pscorbett/ScannerVibrato-Eurorack/README.md

# ScannerVibrato-Eurorack
Scanner vibrato eurorack module that uses digital logic chips (no MCU) to perform the scanning across the LC ladder.
