pscorbett/ScannerVibrato-Eurorack/Mechanical/ScannerVibrato20HP_3D-Assembly.step

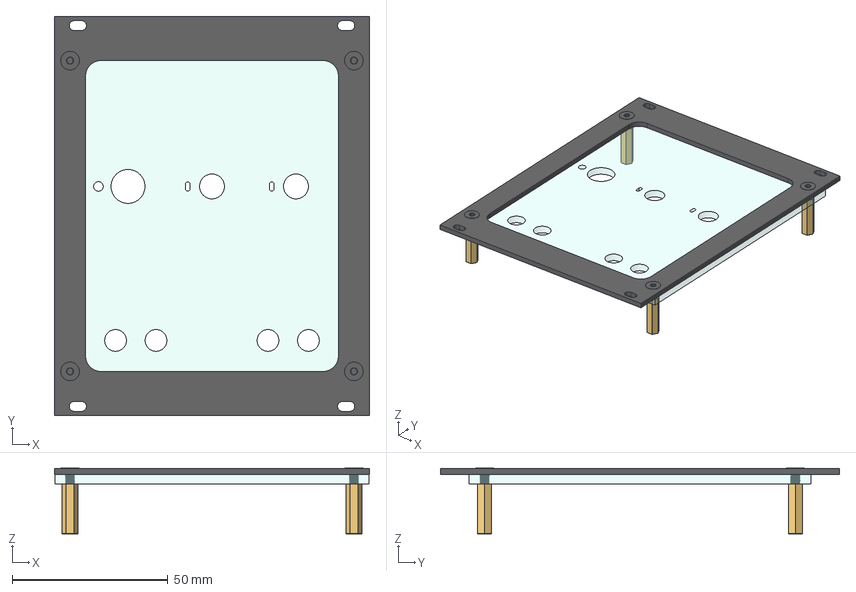
[picture p1: CAD file, 2025-08-02]
Mechanical/ScannerVibrato20HP_3D-Assembly.step
101.3 x 128.4 x 21.1 mm
Frame002
Window001
95440A104_Black-Oxide 316 Stainless Steel Hex Drive Flat Head Screw x 4
95440A104_Black-Oxide 316 Stainless Steel Hex Drive Flat Head Screw001 x 4
