pscorbett/ScannerVibrato-Eurorack/Electronics/Boards/ScannerVibrato_Main/ScannerVibratoFun_Eurorack-Bottom Signal.dxf

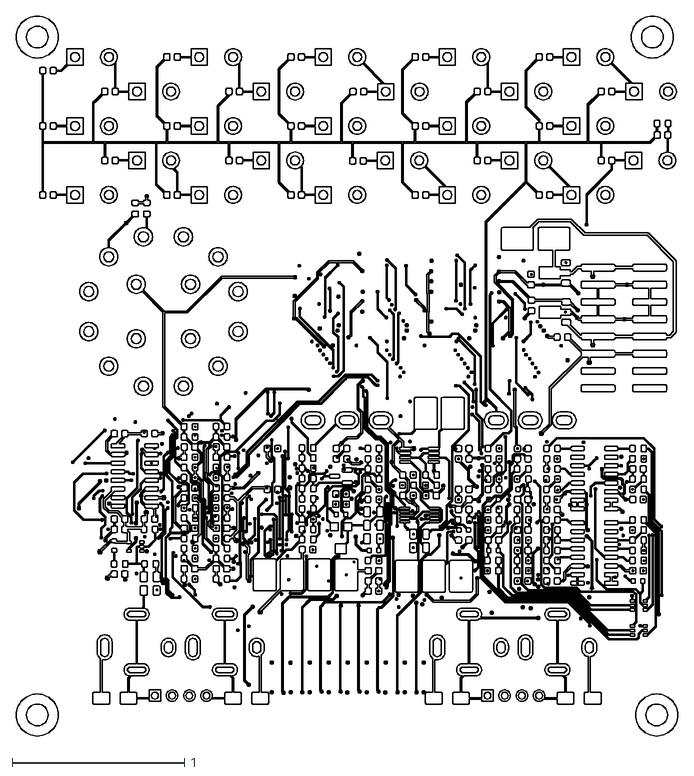
[picture p2: CAD file, 2025-08-02]
Electronics/Boards/ScannerVibrato_Main/ScannerVibratoFun_Eurorack-Bottom Signal.dxf
3.84 x 4.18
