pscorbett/ScannerVibrato-Eurorack/Mechanical/ScannerVibrato20HP_3D-Window001Sketch005.dxf

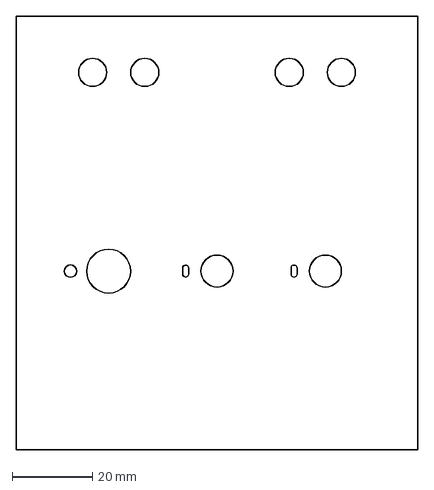
[picture p3: CAD file, 2025-08-02]
Mechanical/ScannerVibrato20HP_3D-Window001Sketch005.dxf
100.0 x 108.0 mm
