pscorbett/ScannerVibrato-Eurorack/Electronics/Boards/ScannerVibrato_Main/ScannerVibratoFun_Eurorack-Board Outline.dxf

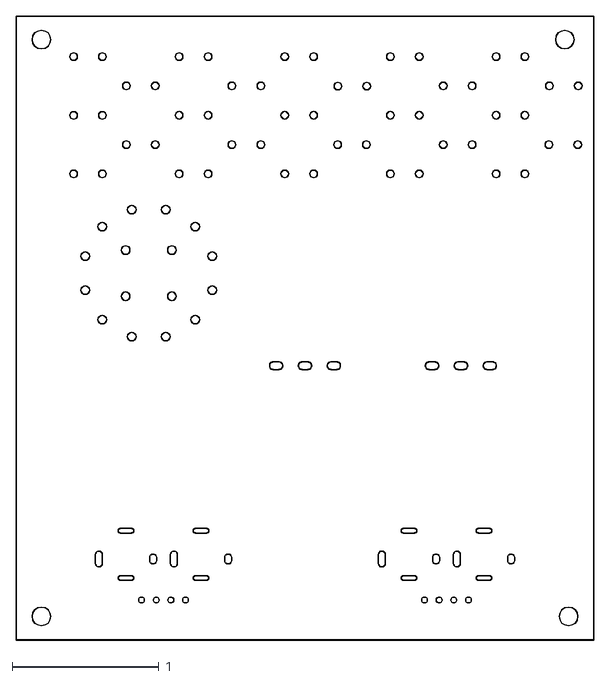
[picture p4: CAD file, 2025-08-02]
Electronics/Boards/ScannerVibrato_Main/ScannerVibratoFun_Eurorack-Board Outline.dxf
3.94 x 4.25
