pscorbett/ScannerVibrato-Eurorack/Mechanical/ScannerVibrato20HP_3D-PanelSketch010.dxf

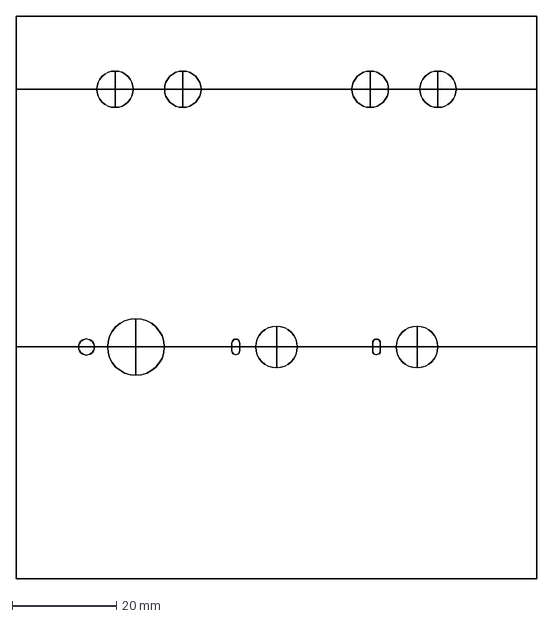
[picture p5: CAD file, 2025-08-02]
Mechanical/ScannerVibrato20HP_3D-PanelSketch010.dxf
100.0 x 108.0 mm
