pscorbett/ScannerVibrato-Eurorack/Electronics/Boards/ScannerVibrato_Main/ScannerVibratoFun_Eurorack-Top Signal.dxf

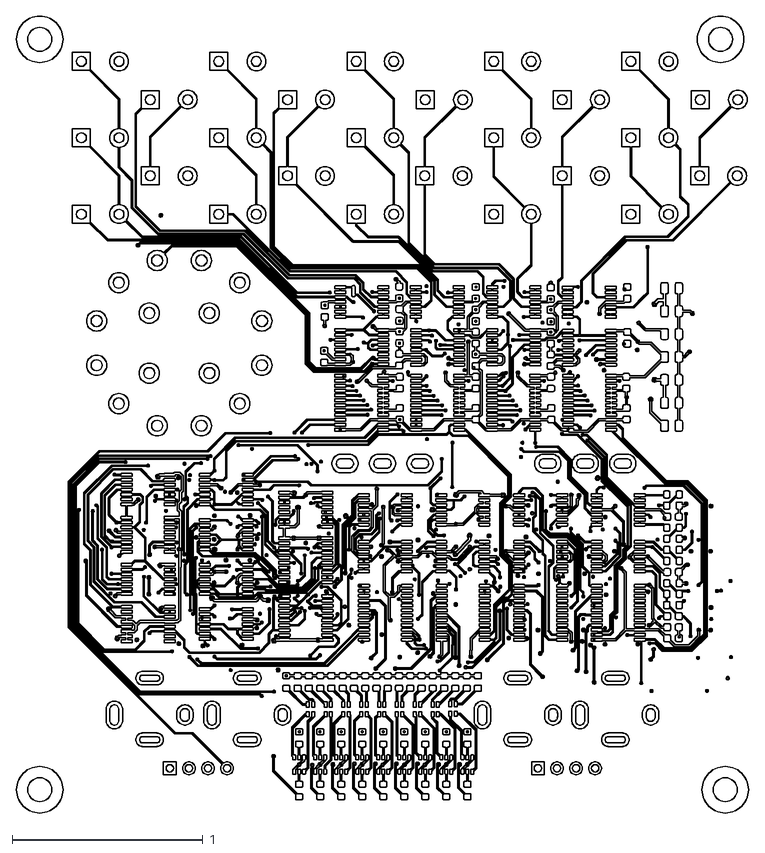
[picture p6: CAD file, 2025-08-02]
Electronics/Boards/ScannerVibrato_Main/ScannerVibratoFun_Eurorack-Top Signal.dxf
3.84 x 4.18
