pscorbett/ScannerVibrato-Eurorack/Mechanical/ScannerVibrato20HP_3D-PanelSketch007.dxf

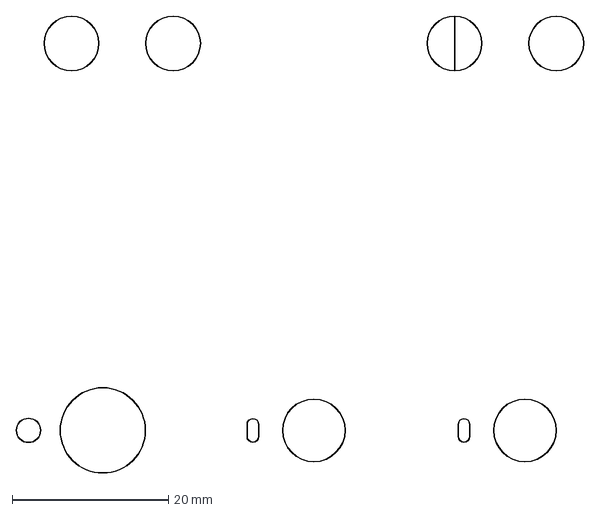
[picture p7: CAD file, 2025-08-02]
Mechanical/ScannerVibrato20HP_3D-PanelSketch007.dxf
72.5 x 58.5 mm
