pscorbett/ScannerVibrato-Eurorack/Mechanical/ScannerVibrato20HP_3D-PartWindow.dxf

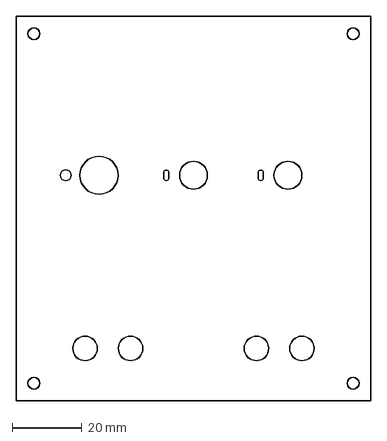
[picture p8: CAD file, 2025-08-02]
Mechanical/ScannerVibrato20HP_3D-PartWindow.dxf
101.3 x 109.9 mm
