pscorbett/ScannerVibrato-Eurorack/(list of files, cad)

Other CAD files:
Electronics/Boards/ScannerVibrato_Main/ScannerVibratoFun_Eurorack-Bottom Silkscreen.dxf
Electronics/Boards/ScannerVibrato_Main/ScannerVibratoFun_Eurorack-Top Silkscreen.dxf
