pscorbett/ScannerVibrato-Eurorack/Electronics/Boards/ScannerVibrato_IO/ScannerVibrato_IO.kicad_pcb

## KiCad design Electronics/Boards/ScannerVibrato_IO/ScannerVibrato_IO.kicad_pcb (2025-08-02)

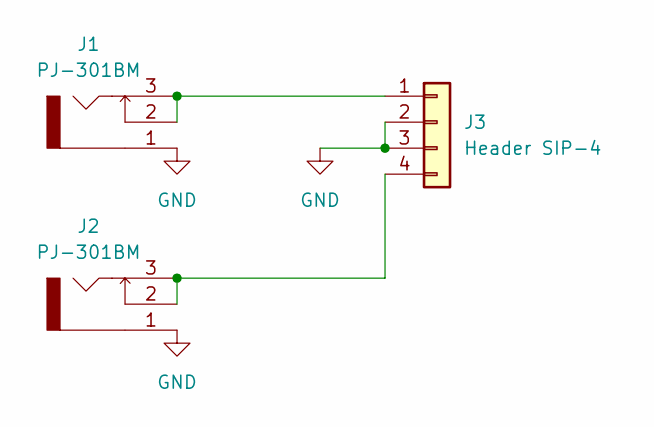
[picture p9: schematic ScannerVibrato_IO.kicad_sch, Scanner Vibrato IO]

Parts:
J1, J2: PJ-301BM; Part Number PJ-301BM
J3: Header SIP-4; PinHeader_1x04_P2.54mm_Vertical; Part Number PH1-04-UA

Connections:
GND: J1.1 (S), J2.1 (S), J3.2, J3.3
unnamed: J1.2 (SW), J1.3 (T), J3.1
unnamed: J2.2 (SW), J2.3 (T), J3.4

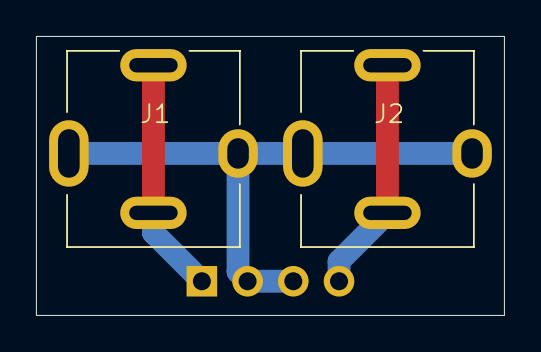
[picture p10: board ScannerVibrato_IO.kicad_pcb from above]

Board: 2 copper layers, 26.0 x 15.5 mm, 3 parts (1 on the bottom side), 3 nets.
