pscorbett/ScannerVibrato-Eurorack/Electronics/Boards/ScannerVibrato_Main/ScannerVibratoFun_Eurorack.kicad_pcb

## KiCad design Electronics/Boards/ScannerVibrato_Main/ScannerVibratoFun_Eurorack.kicad_pcb (2025-08-02)

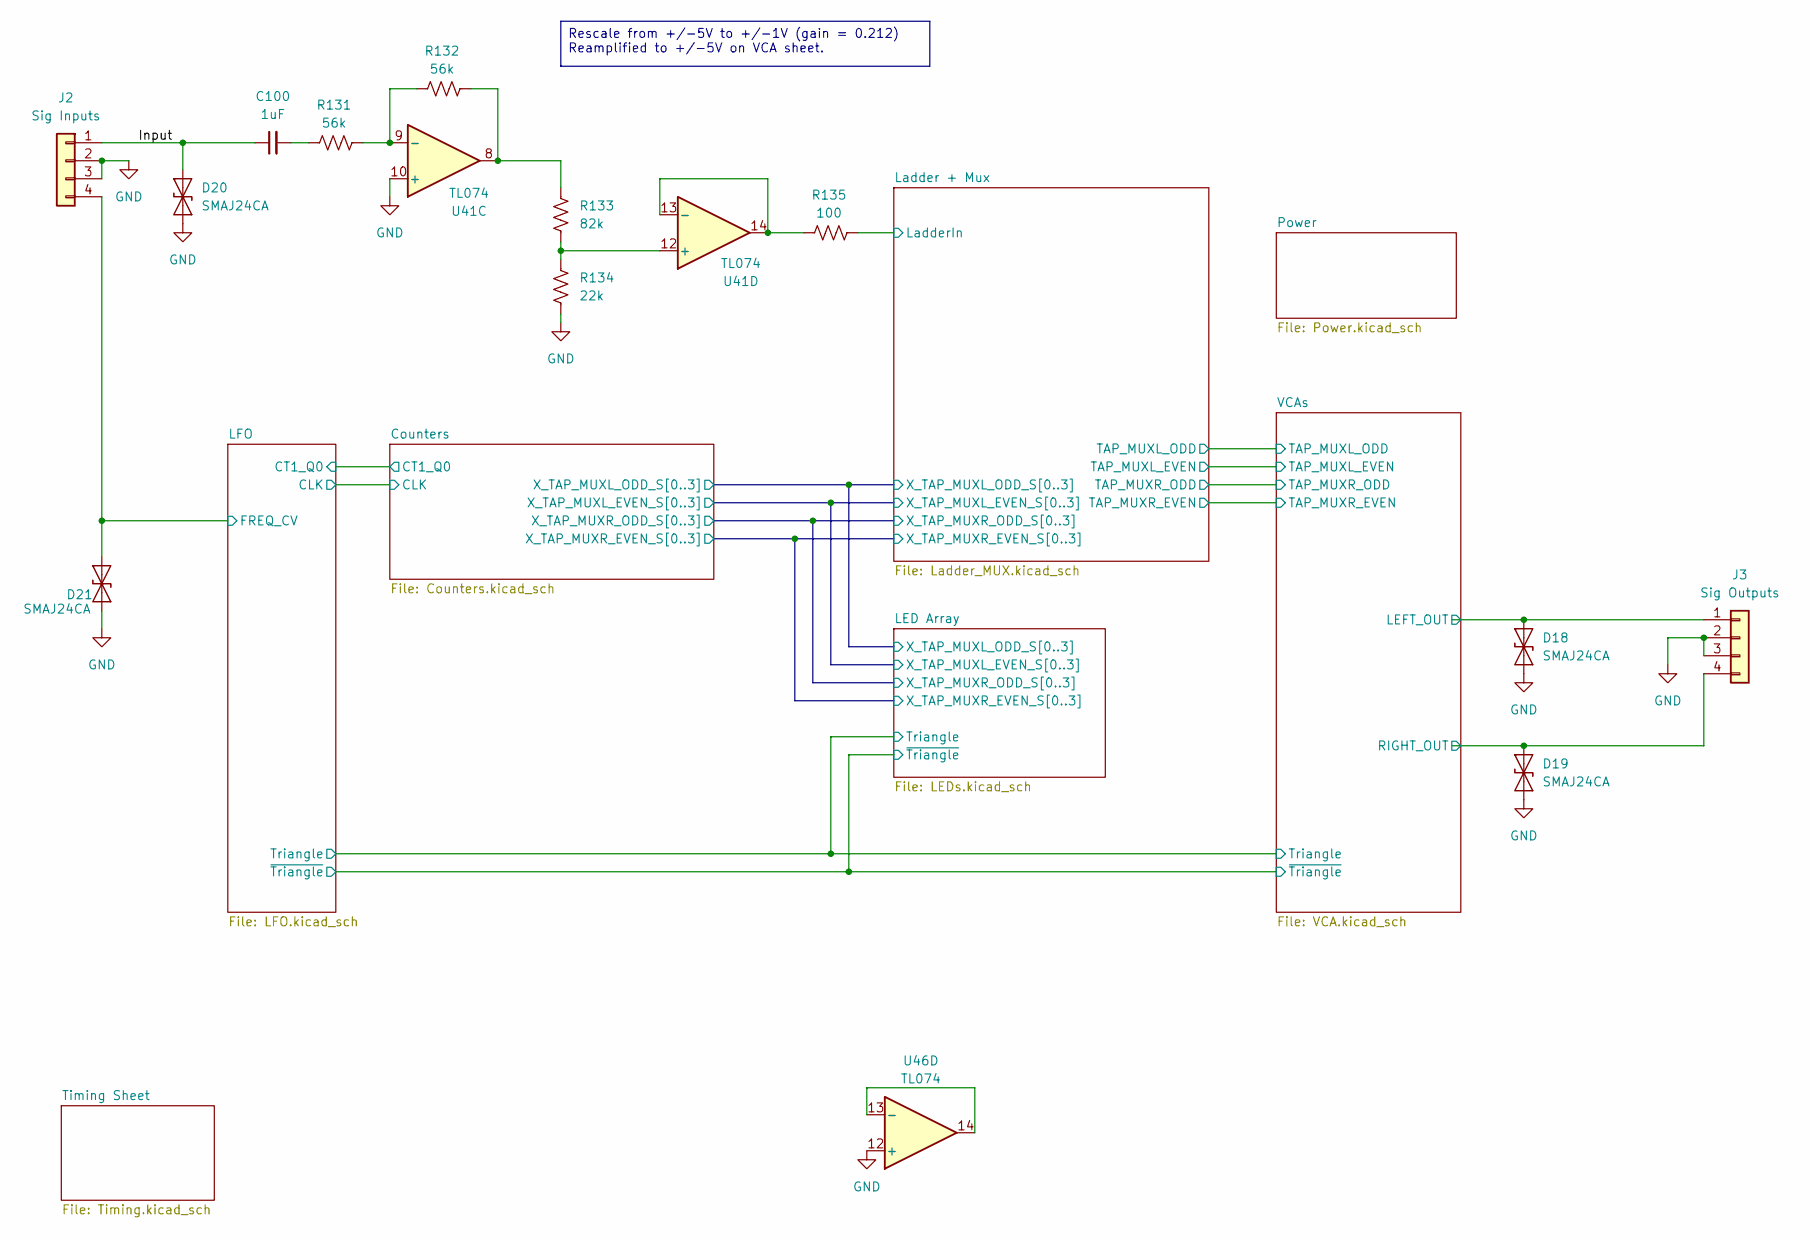
[picture p11: schematic ScannerVibratoFun_Eurorack.kicad_sch, Solid State Scanner Vibrato]

Parts:
C100: 1uF; C_0805_2012Metric
D18, D19, D20, D21: SMAJ24CA; D_SMA
J2: Sig Inputs; IO_Jack_Header
J3: Sig Outputs; IO_Jack_Header
R131, R132: 56k; R_0603_1608Metric
R133: 82k; R_0603_1608Metric
R134: 22k; R_0603_1608Metric
R135: 100; R_0603_1608Metric
U41, U46: TL074; TSSOP-14_4.4x5mm_P0.65mm; Part Number TL074HIPWR

Connections:
/Input: C100.1, D20.2 (A2), J2.1
/LFO/FREQ_CV: D21.2 (A2), J2.4; also elsewhere on the board
/Ladder + Mux/LadderIn: R135.2; also elsewhere on the board
/VCAs/LEFT_OUT: D18.2 (A2), J3.1; also elsewhere on the board
/VCAs/RIGHT_OUT: D19.2 (A2), J3.4; also elsewhere on the board
GND: D18.1 (A1), D19.1 (A1), D20.1 (A1), D21.1 (A1), J2.2, J2.3, J3.2, J3.3, R134.1, U41.10 (+), U46.12 (+); also elsewhere on the board
unnamed: C100.2, R131.1
unnamed: R132.2, R133.2, U41.8
unnamed: R131.2, R132.1, U41.9 (-)
unnamed: R133.1, R134.2, U41.12 (+)
unnamed: R135.1, U41.13 (-), U41.14
unnamed: U46.13 (-), U46.14

Notes on the sheet:
Rescale from +/-5V to +/-1V (gain = 0.212) Reamplified to +/-5V on VCA sheet.

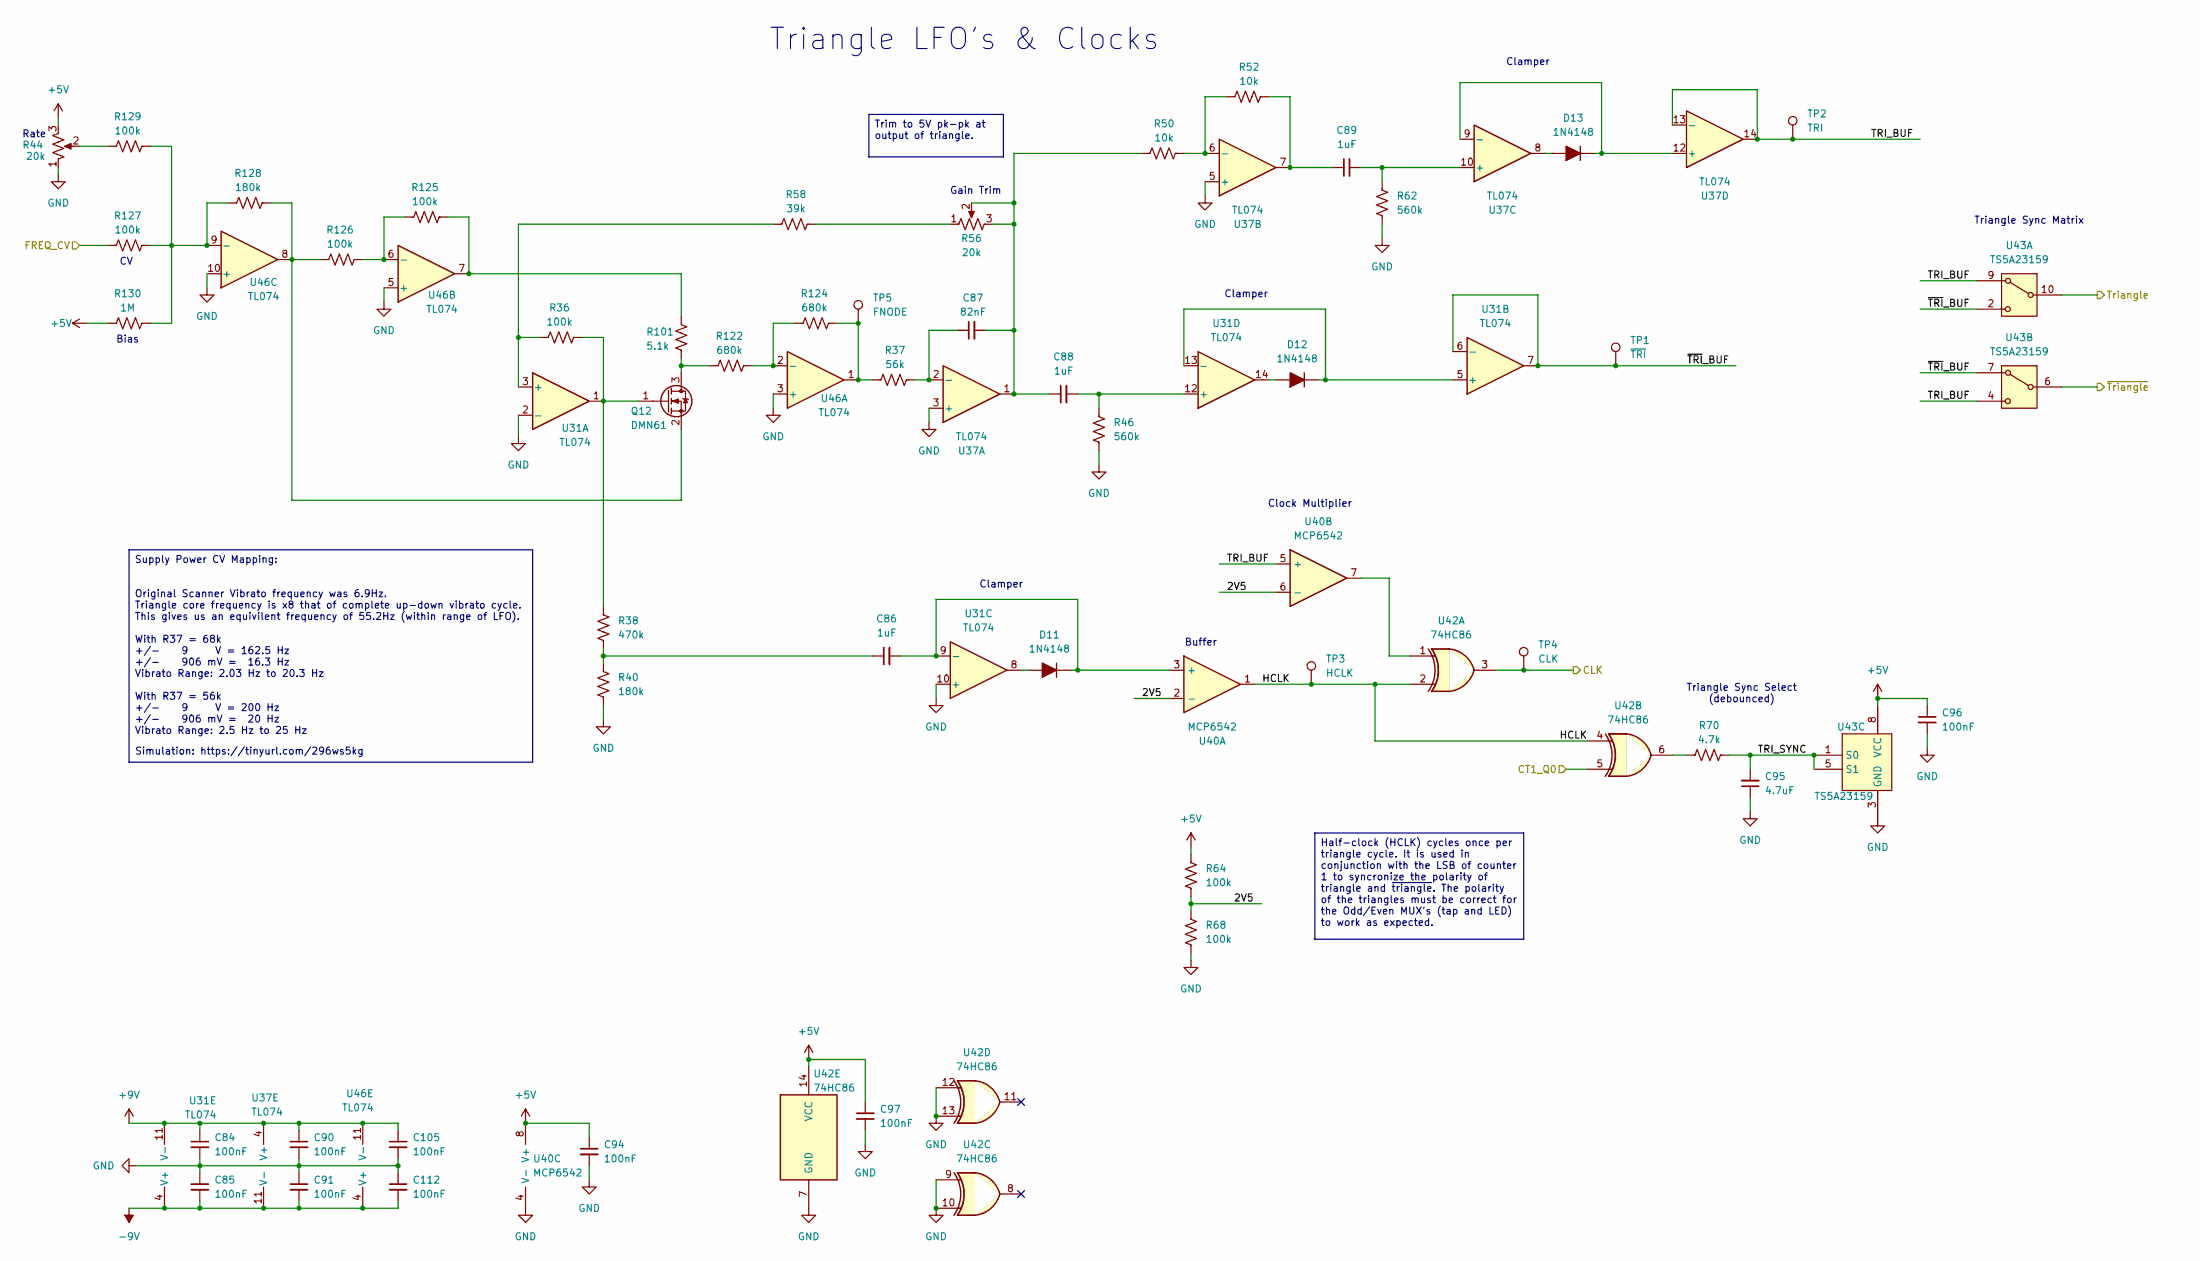
[picture p12: schematic LFO.kicad_sch, Solid State Scanner Vibrato]

Parts:
C84, C85, C90, C91, C94, C96, C97, C105, C112: 100nF; C_0603_1608Metric
C86, C88, C89: 1uF; C_0805_2012Metric
C87: 82nF; C_0805_2012Metric
C95: 4.7uF; C_0805_2012Metric
D11, D12, D13: 1N4148; D_SOD-523; Part Number 1N4148WT
Q12: DMN61; SOT-23; Part Number DMN61D9UWQ-13
R36, R64, R68, R125, R126, R127, R129: 100k; R_0603_1608Metric
R37: 56k; R_0603_1608Metric
R38: 470k; R_0603_1608Metric
R40, R128: 180k; R_0603_1608Metric
R44: 20k; 16mm-POT-Right-Angle_LL; Part Number RV16AF-4M-15R1-B20K-EV
R46, R62: 560k; R_0603_1608Metric
R50, R52: 10k; R_0603_1608Metric
R56: 20k; Potentiometer_Bourns_TC33X_Vertical_Fixed3D; Part Number TC33X-2-203E
R58: 39k; R_0603_1608Metric
R70: 4.7k; R_0603_1608Metric
R101: 5.1k; R_0603_1608Metric
R122, R124: 680k; R_0603_1608Metric
R130: 1M; R_0603_1608Metric
TP1: ~{TRI}; 5016; Part Number 5016
TP2: TRI; 5016; Part Number 5016
TP3: HCLK; 5016; Part Number 5016
TP4: CLK; 5016; Part Number 5016
TP5: FNODE; 5016; Part Number 5016
U31, U37, U46: TL074; TSSOP-14_4.4x5mm_P0.65mm; Part Number TL074HIPWR
U40: MCP6542; MSOP-8_3x3mm_P0.65mm; Part Number MCP6542T-I/MS
U42: 74HC86; TSSOP-14_4.4x5mm_P0.65mm; Part Number SN74HC86PWR
U43: TS5A23159; VSSOP-10_3x3mm_P0.5mm; Part Number TS5A23159DGSR

Connections:
+5V: C94.1, C96.1, C97.1, R44.3, R64.2, R130.1, U40.8 (V+), U42.14 (VCC), U43.8 (VCC); also elsewhere on the board
+9V: C84.1, C90.1, C105.1, U31.11 (V-), U37.4 (V+), U46.11 (V-); also elsewhere on the board
-9V: C85.2, C91.2, C112.2, U31.4 (V+), U37.11 (V-), U46.4 (V+); also elsewhere on the board
/Counters/CLK: TP4.1, U42.3; also elsewhere on the board
/Counters/CT1_Q0: U42.5; also elsewhere on the board
/LED Array/Triangle: U43.10 (COM0); also elsewhere on the board
/LED Array/~Triangle: U43.6 (COM1); also elsewhere on the board
/LFO/2V5: R64.1, R68.2, U40.2 (-), U40.6 (-)
/LFO/FREQ_CV: R127.1; also elsewhere on the board
/LFO/HCLK: TP3.1, U40.1, U42.2, U42.4
/LFO/TRI_BUF: TP2.1, U37.13 (-), U37.14, U40.5 (+), U43.4 (NO0), U43.9 (NC0)
/LFO/TRI_SYNC: C95.2, R70.2, U43.1 (S0), U43.5 (S1)
/LFO/~TRI_BUF: TP1.1, U31.6 (-), U31.7, U43.2 (NO0), U43.7 (NC1)
GND: C84.2, C85.1, C90.2, C91.1, C94.2, C95.1, C96.2, C97.2, C105.2, C112.1, R40.1, R44.1, R46.1, R62.1, R68.1, U31.2 (-), U31.10 (+), U37.3 (+), U37.5 (+), U40.4 (V-), U42.7 (GND), U42.9, U42.10, U42.12, U42.13, U43.3 (GND), U46.3 (+), U46.5 (+), U46.10 (+); also elsewhere on the board
unnamed: C86.1, R38.1, R40.2
unnamed: C87.2, C88.1, R50.1, R56.2, R56.3, U37.1
unnamed: C89.1, R52.2, U37.7
unnamed: D11.2 (A), U31.8
unnamed: C86.2, D11.1 (K), U31.9 (-), U40.3 (+)
unnamed: D12.2 (A), U31.14
unnamed: D12.1 (K), U31.5 (+), U31.13 (-)
unnamed: D13.2 (A), U37.8
unnamed: D13.1 (K), U37.9 (-), U37.12 (+)
unnamed: Q12.3 (D), R101.1, R122.1
unnamed: Q12.1 (G), R36.2, R38.2, U31.1
unnamed: Q12.2 (S), R126.1, R128.2, U46.8
unnamed: R56.1, R58.2
unnamed: R70.1, U42.6
unnamed: R101.2, R125.2, U46.7
unnamed: R37.1, R124.2, TP5.1, U46.1
unnamed: R44.2, R129.1
unnamed: R36.1, R58.1, U31.3 (+)
unnamed: C88.2, R46.2, U31.12 (+)
unnamed: C87.1, R37.2, U37.2 (-)
unnamed: R50.2, R52.1, U37.6 (-)
unnamed: C89.2, R62.2, U37.10 (+)
unnamed: U40.7, U42.1
unnamed: R122.2, R124.1, U46.2 (-)
unnamed: R125.1, R126.2, U46.6 (-)
unnamed: R127.2, R128.1, R129.2, R130.2, U46.9 (-)

Notes on the sheet:
Triangle LFO's & Clocks
Clamper
Triangle Sync Select (debounced)
Triangle Sync Matrix
Buffer
Bias
Gain Trim
Clock Multiplier
Simulation: https://tinyurl.com/296ws5kg
Rate
Half-clock (HCLK) cycles once per triangle cycle. It is used in conjunction with the LSB of counter 1 to syncronize the polarity of triangle and ~{triangle}. The polarity of the triangles must be correct for the Odd/Even MUX's (tap and LED) to work as expected.
Trim to 5V pk-pk at output of triangle.
Supply Power CV Mapping: Original Scanner Vibrato frequency was 6.9Hz. Triangle core frequency is x8 that of complete up-down vibrato cycle. This gives us an equivilent frequency of 55.2Hz (within range of LFO). With R37 = 68k +/- 9 V = 162.5 Hz +/- 906 mV = 16.3 Hz Vibrato Range: 2.03 Hz to 20.3 H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

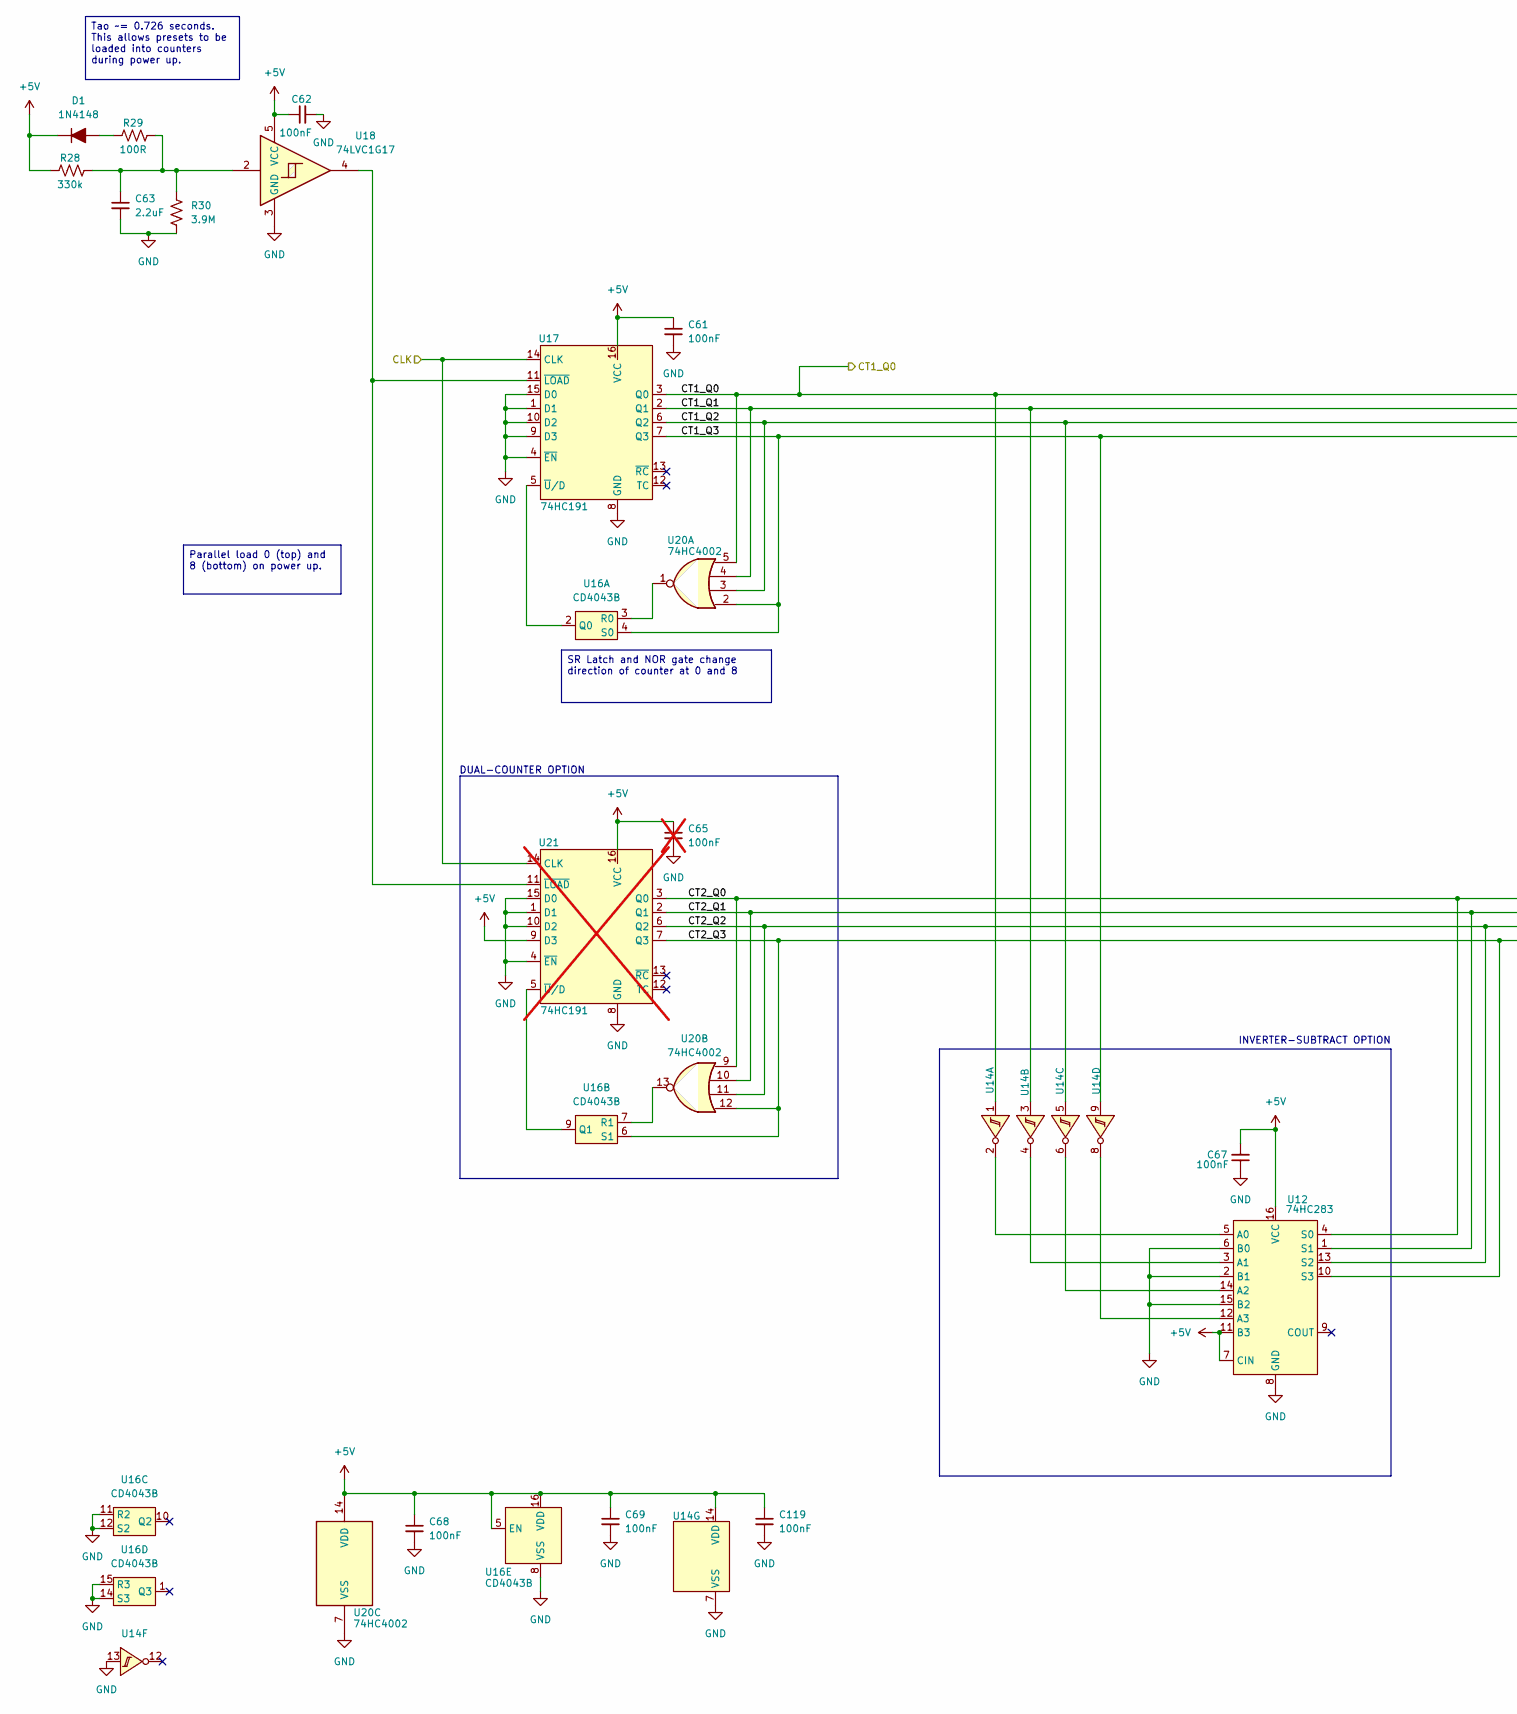
[picture p13: schematic Counters.kicad_sch, Solid State Scanner Vibrato, part in row 1, column 1]

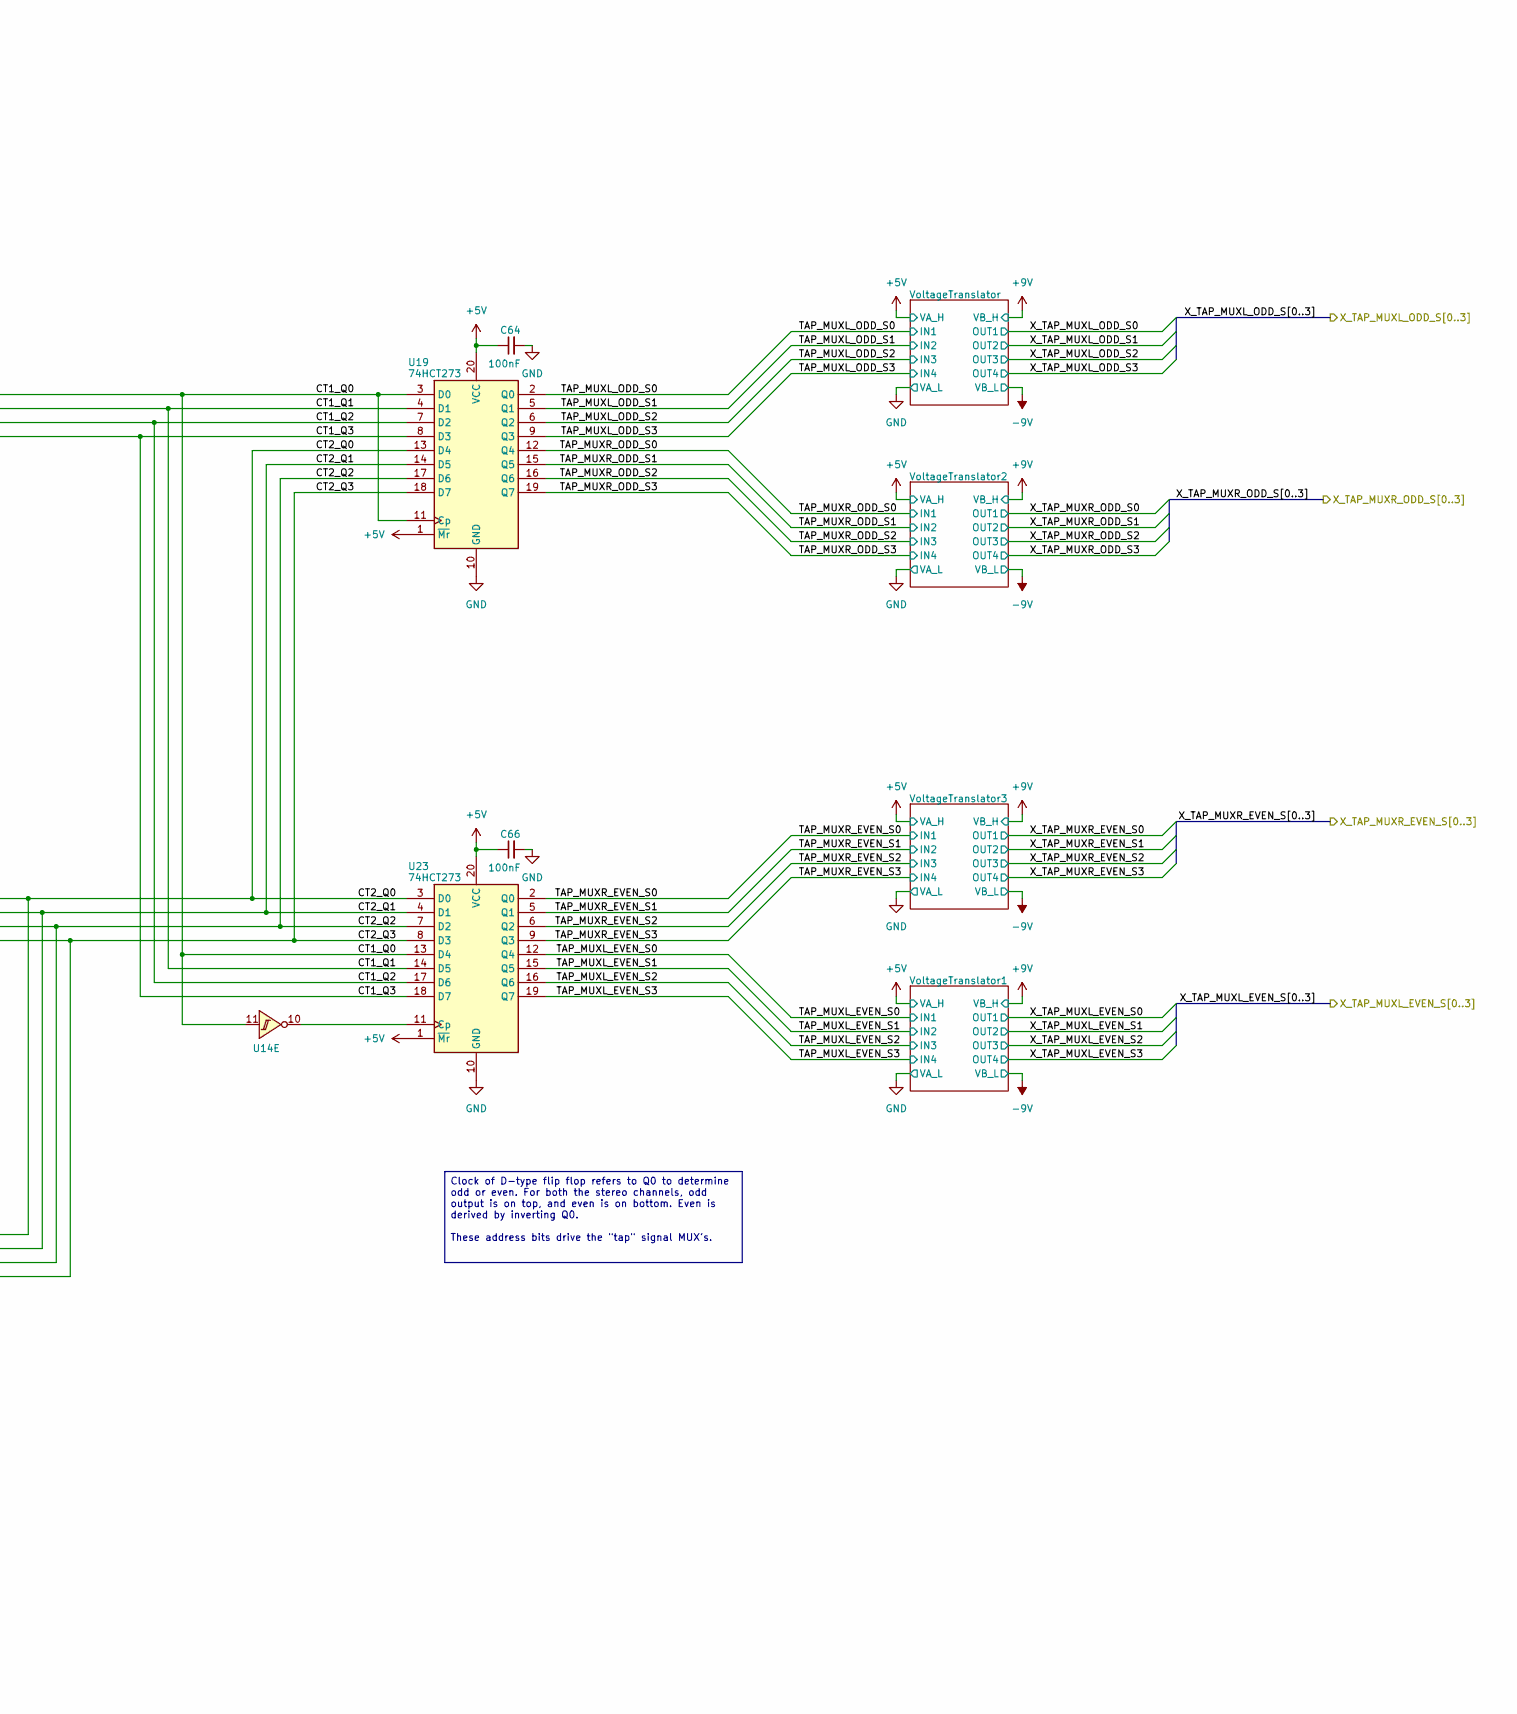
[picture p14: schematic Counters.kicad_sch, Solid State Scanner Vibrato, part in row 1, column 2]

Parts:
C61, C62, C64, C66, C67, C68, C69, C119: 100nF; C_0603_1608Metric
C63: 2.2uF; C_0805_2012Metric
C65: 100nF; C_0603_1608Metric; not fitted
D1: 1N4148; D_SOD-523; Part Number 1N4148WT
R28: 330k; R_0603_1608Metric
R29: 100R; R_0603_1608Metric
R30: 3.9M; R_0603_1608Metric
U12: 74HC283; SOIC-16_3.9x9.9mm_P1.27mm; Part Number CD74HC283M96
U14: CD40106; TSSOP-14_4.4x5mm_P0.65mm; Part Number CD40106BPWR
U16: CD4043B; TSSOP-16_4.4x5mm_P0.65mm; Part Number CD4043BPWR
U17: 74HC191; TSSOP-16_4.4x5mm_P0.65mm; Part Number 74HC191PW,118
U18: 74LVC1G17; SOT-353_SC-70-5; Part Number SN74LVC1G17DCKR
U19, U23: 74HCT273; TSSOP-20_4.4x6.5mm_P0.65mm; Part Number SN74HCT273PWR
U20: 74HC4002; TSSOP-14_4.4x5mm_P0.65mm; Part Number CD74HC4002PWR
U21: 74HC191; TSSOP-16_4.4x5mm_P0.65mm; Part Number 74HC191PW,118; not fitted

Connections:
+5V: C61.1, C62.1, C64.1, C65.1, C66.1, C67.2, C68.1, C69.1, C119.1, D1.1 (K), R28.1, U12.7 (CIN), U12.11 (B3), U12.16 (VCC), U14.14 (VDD), U16.5 (EN), U16.16 (VDD), U17.16 (VCC), U18.5 (VCC), U19.1 (~Mr), U19.20 (VCC), U20.14 (VDD), U21.9 (D3), U21.16 (VCC), U23.1 (~Mr), U23.20 (VCC); also elsewhere on the board
/Counters/CLK: U17.14 (CLK), U21.14 (CLK); also elsewhere on the board
/Counters/CT1_Q0: U14.1 (A), U14.11 (E), U17.3 (Q0), U19.3 (D0), U19.11 (Cp), U20.5, U23.13 (D4); also elsewhere on the board
/Counters/CT1_Q1: U14.3 (B), U17.2 (Q1), U19.4 (D1), U20.4, U23.14 (D5)
/Counters/CT1_Q2: U14.5 (C), U17.6 (Q2), U19.7 (D2), U20.3, U23.17 (D6)
/Counters/CT1_Q3: U14.9 (D), U16.4 (S0), U17.7 (Q3), U19.8 (D3), U20.2, U23.18 (D7)
/Counters/CT2_Q0: U12.4 (S0), U19.13 (D4), U20.9, U21.3 (Q0), U23.3 (D0)
/Counters/CT2_Q1: U12.1 (S1), U19.14 (D5), U20.10, U21.2 (Q1), U23.4 (D1)
/Counters/CT2_Q2: U12.13 (S2), U19.17 (D6), U20.11, U21.6 (Q2), U23.7 (D2)
/Counters/CT2_Q3: U12.10 (S3), U16.6 (S1), U19.18 (D7), U20.12, U21.7 (Q3), U23.8 (D3)
/Counters/TAP_MUXL_EVEN_S0: U23.12 (Q4); also elsewhere on the board
/Counters/TAP_MUXL_EVEN_S1: U23.15 (Q5); also elsewhere on the board
/Counters/TAP_MUXL_EVEN_S2: U23.16 (Q6); also elsewhere on the board
/Counters/TAP_MUXL_EVEN_S3: U23.19 (Q7); also elsewhere on the board
/Counters/TAP_MUXL_ODD_S0: U19.2 (Q0); also elsewhere on the board
/Counters/TAP_MUXL_ODD_S1: U19.5 (Q1); also elsewhere on the board
/Counters/TAP_MUXL_ODD_S2: U19.6 (Q2); also elsewhere on the board
/Counters/TAP_MUXL_ODD_S3: U19.9 (Q3); also elsewhere on the board
/Counters/TAP_MUXR_EVEN_S0: U23.2 (Q0); also elsewhere on the board
/Counters/TAP_MUXR_EVEN_S1: U23.5 (Q1); also elsewhere on the board
/Counters/TAP_MUXR_EVEN_S2: U23.6 (Q2); also elsewhere on the board
/Counters/TAP_MUXR_EVEN_S3: U23.9 (Q3); also elsewhere on the board
/Counters/TAP_MUXR_ODD_S0: U19.12 (Q4); also elsewhere on the board
/Counters/TAP_MUXR_ODD_S1: U19.15 (Q5); also elsewhere on the board
/Counters/TAP_MUXR_ODD_S2: U19.16 (Q6); also elsewhere on the board
/Counters/TAP_MUXR_ODD_S3: U19.19 (Q7); also elsewhere on the board
GND: C61.2, C62.2, C63.2, C64.2, C65.2, C66.2, C67.1, C68.2, C69.2, C119.2, R30.2, U12.2 (B1), U12.6 (B0), U12.8 (GND), U12.15 (B2), U14.7 (VSS), U14.13 (F), U16.8 (VSS), U16.11 (R2), U16.12 (S2), U16.14 (S3), U16.15 (R3), U17.1 (D1), U17.4 (~EN), U17.8 (GND), U17.9 (D3), U17.10 (D2), U17.15 (D0), U18.3 (GND), U19.10 (GND), U20.7 (VSS), U21.1 (D1), U21.4 (~EN), U21.8 (GND), U21.10 (D2), U21.15 (D0), U23.10 (GND); also elsewhere on the board
unnamed: C63.1, R28.2, R29.2, R30.1, U18.2
unnamed: D1.2 (A), R29.1
unnamed: U12.5 (A0), U14.2 (~A)
unnamed: U12.3 (A1), U14.4 (~B)
unnamed: U12.14 (A2), U14.6 (~C)
unnamed: U12.12 (A3), U14.8 (~D)
unnamed: U14.10 (~E), U23.11 (Cp)
unnamed: U16.2 (Q0), U17.5 (~U/D)
unnamed: U16.3 (R0), U20.1
unnamed: U16.9 (Q1), U21.5 (~U/D)
unnamed: U16.7 (R1), U20.13
unnamed: U17.11 (~LOAD), U18.4, U21.11 (~LOAD)

Notes on the sheet:
DUAL-COUNTER OPTION
INVERTER-SUBTRACT OPTION
Tao ~= 0.726 seconds. This allows presets to be loaded into counters during power up.
SR Latch and NOR gate change direction of counter at 0 and 8
Clock of D-type flip flop refers to Q0 to determine odd or even. For both the stereo channels, odd output is on top, and even is on bottom. Even is derived by inverting Q0. These address bits drive the "tap" signal MUX's.
Parallel load 0 (top) and 8 (bottom) on power up.

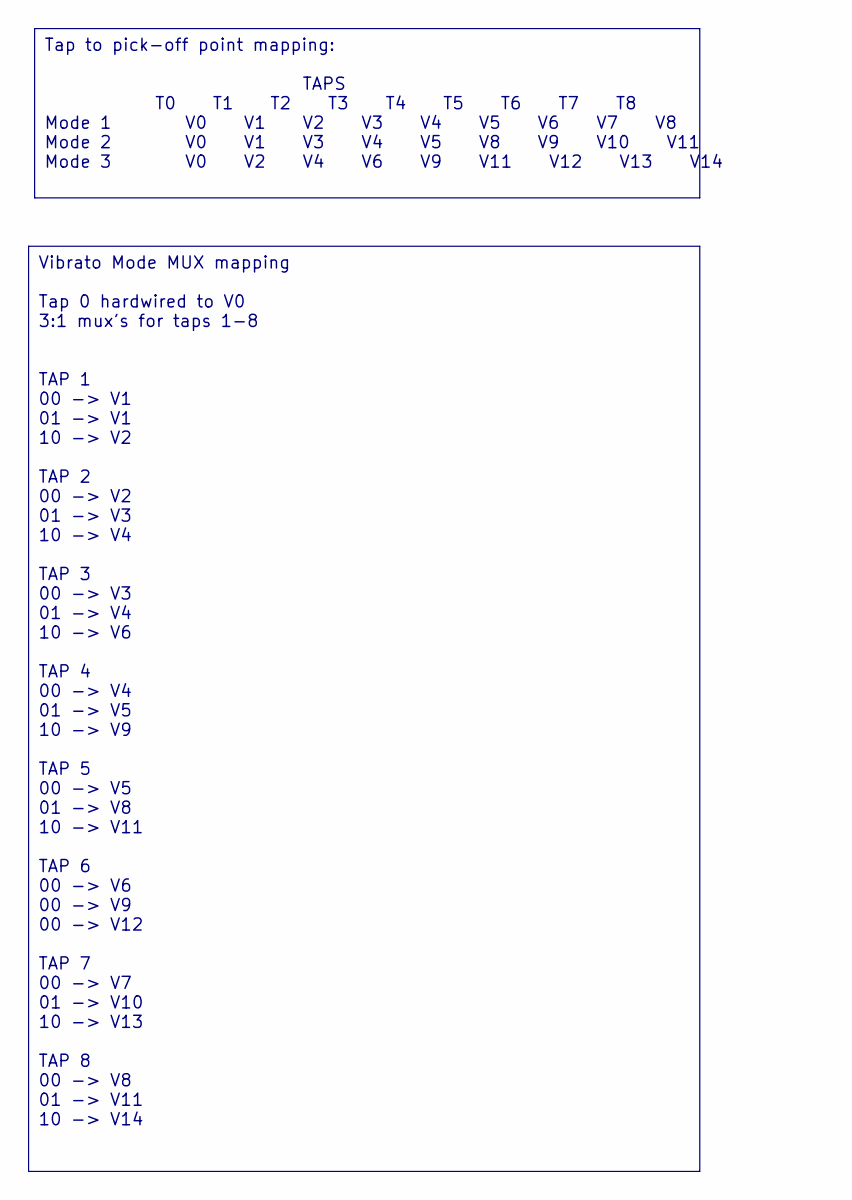
[picture p15: schematic Timing.kicad_sch, Solid State Scanner Vibrato]

Notes on the sheet:
Tap to pick-off point mapping: TAPS T0 T1 T2 T3 T4 T5 T6 T7 T8 Mode 1 V0 V1 V2 V3 V4 V5 V6 V7 V8 Mode 2 V0 V1 V3 V4 V5 V8 V9 V10 V11 Mode 3 V0 V2 V4 V6 V9 V11 V12 V13 V14
Vibrato Mode MUX mapping Tap 0 hardwired to V0 3:1 mux's for taps 1-8 TAP 1 00 -> V1 01 -> V1 10 -> V2 TAP 2 00 -> V2 01 -> V3 10 -> V4 TAP 3 00 -> V3 01 -> V4 10 -> V6 TAP 4 00 -> V4 01 -> V5 10 -> V9 TAP 5 00 -> V5 01 -> V8 10 -> V11 TAP 6 00 -> V6 00 -> V9 00 -> V12 TAP 7 00 -> V7 01 -> V10 10 -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

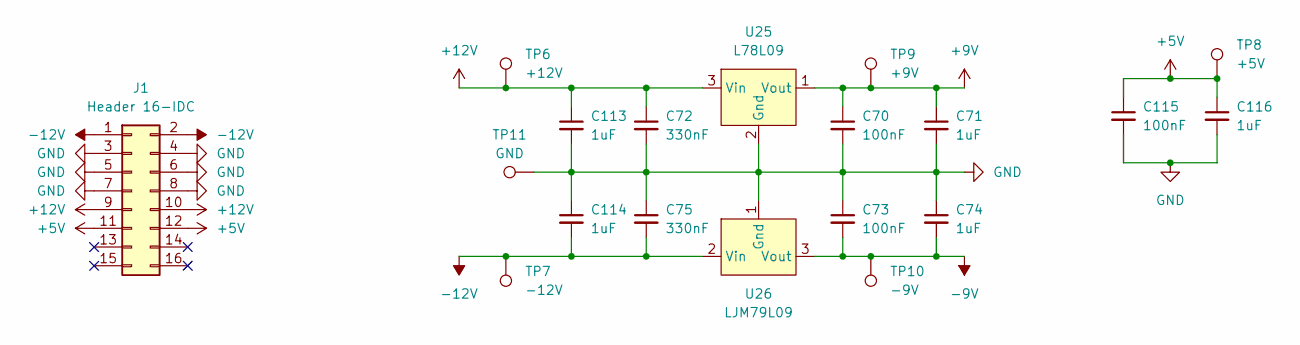
[picture p16: schematic Power.kicad_sch, Solid State Scanner Vibrato]

Parts:
C70, C73, C115: 100nF; C_0603_1608Metric
C71, C74, C113, C114, C116: 1uF; C_0805_2012Metric
C72, C75: 330nF; C_0805_2012Metric
J1: Header 16-IDC; IDC-Header_2x08_P2.54mm_Vertical_SMD; Part Number 3020-16-0300-00
TP6: +12V; 5016; Part Number 5016
TP7: -12V; 5016; Part Number 5016
TP8: +5V; 5016; Part Number 5016
TP9: +9V; 5016; Part Number 5016
TP10: -9V; 5016; Part Number 5016
TP11: GND; 5016; Part Number 5016
U25: L78L09; SOT-89-3; Part Number L78L09ACUTR
U26: LJM79L09; SOT-89-3; Part Number NJM79L09SU3-TE1

Connections:
+5V: C115.1, C116.1, J1.11, J1.12, TP8.1; also elsewhere on the board
+9V: C70.1, C71.1, TP9.1, U25.1 (Vout); also elsewhere on the board
+12V: C72.1, C113.1, J1.9, J1.10, TP6.1, U25.3 (Vin)
-9V: C73.2, C74.2, TP10.1, U26.3 (Vout); also elsewhere on the board
-12V: C75.2, C114.2, J1.1, J1.2, TP7.1, U26.2 (Vin)
GND: C70.2, C71.2, C72.2, C73.1, C74.1, C75.1, C113.2, C114.1, C115.2, C116.2, J1.3, J1.4, J1.5, J1.6, J1.7, J1.8, TP11.1, U25.2 (Gnd), U26.1 (Gnd); also elsewhere on the board
