pscorbett/ScannerVibrato-Eurorack/Electronics/Boards/ScannerVibrato_Main/ScannerVibratoFun_Eurorack.kicad_pcb

## KiCad design Electronics/Boards/ScannerVibrato_Main/ScannerVibratoFun_Eurorack.kicad_pcb (continued)

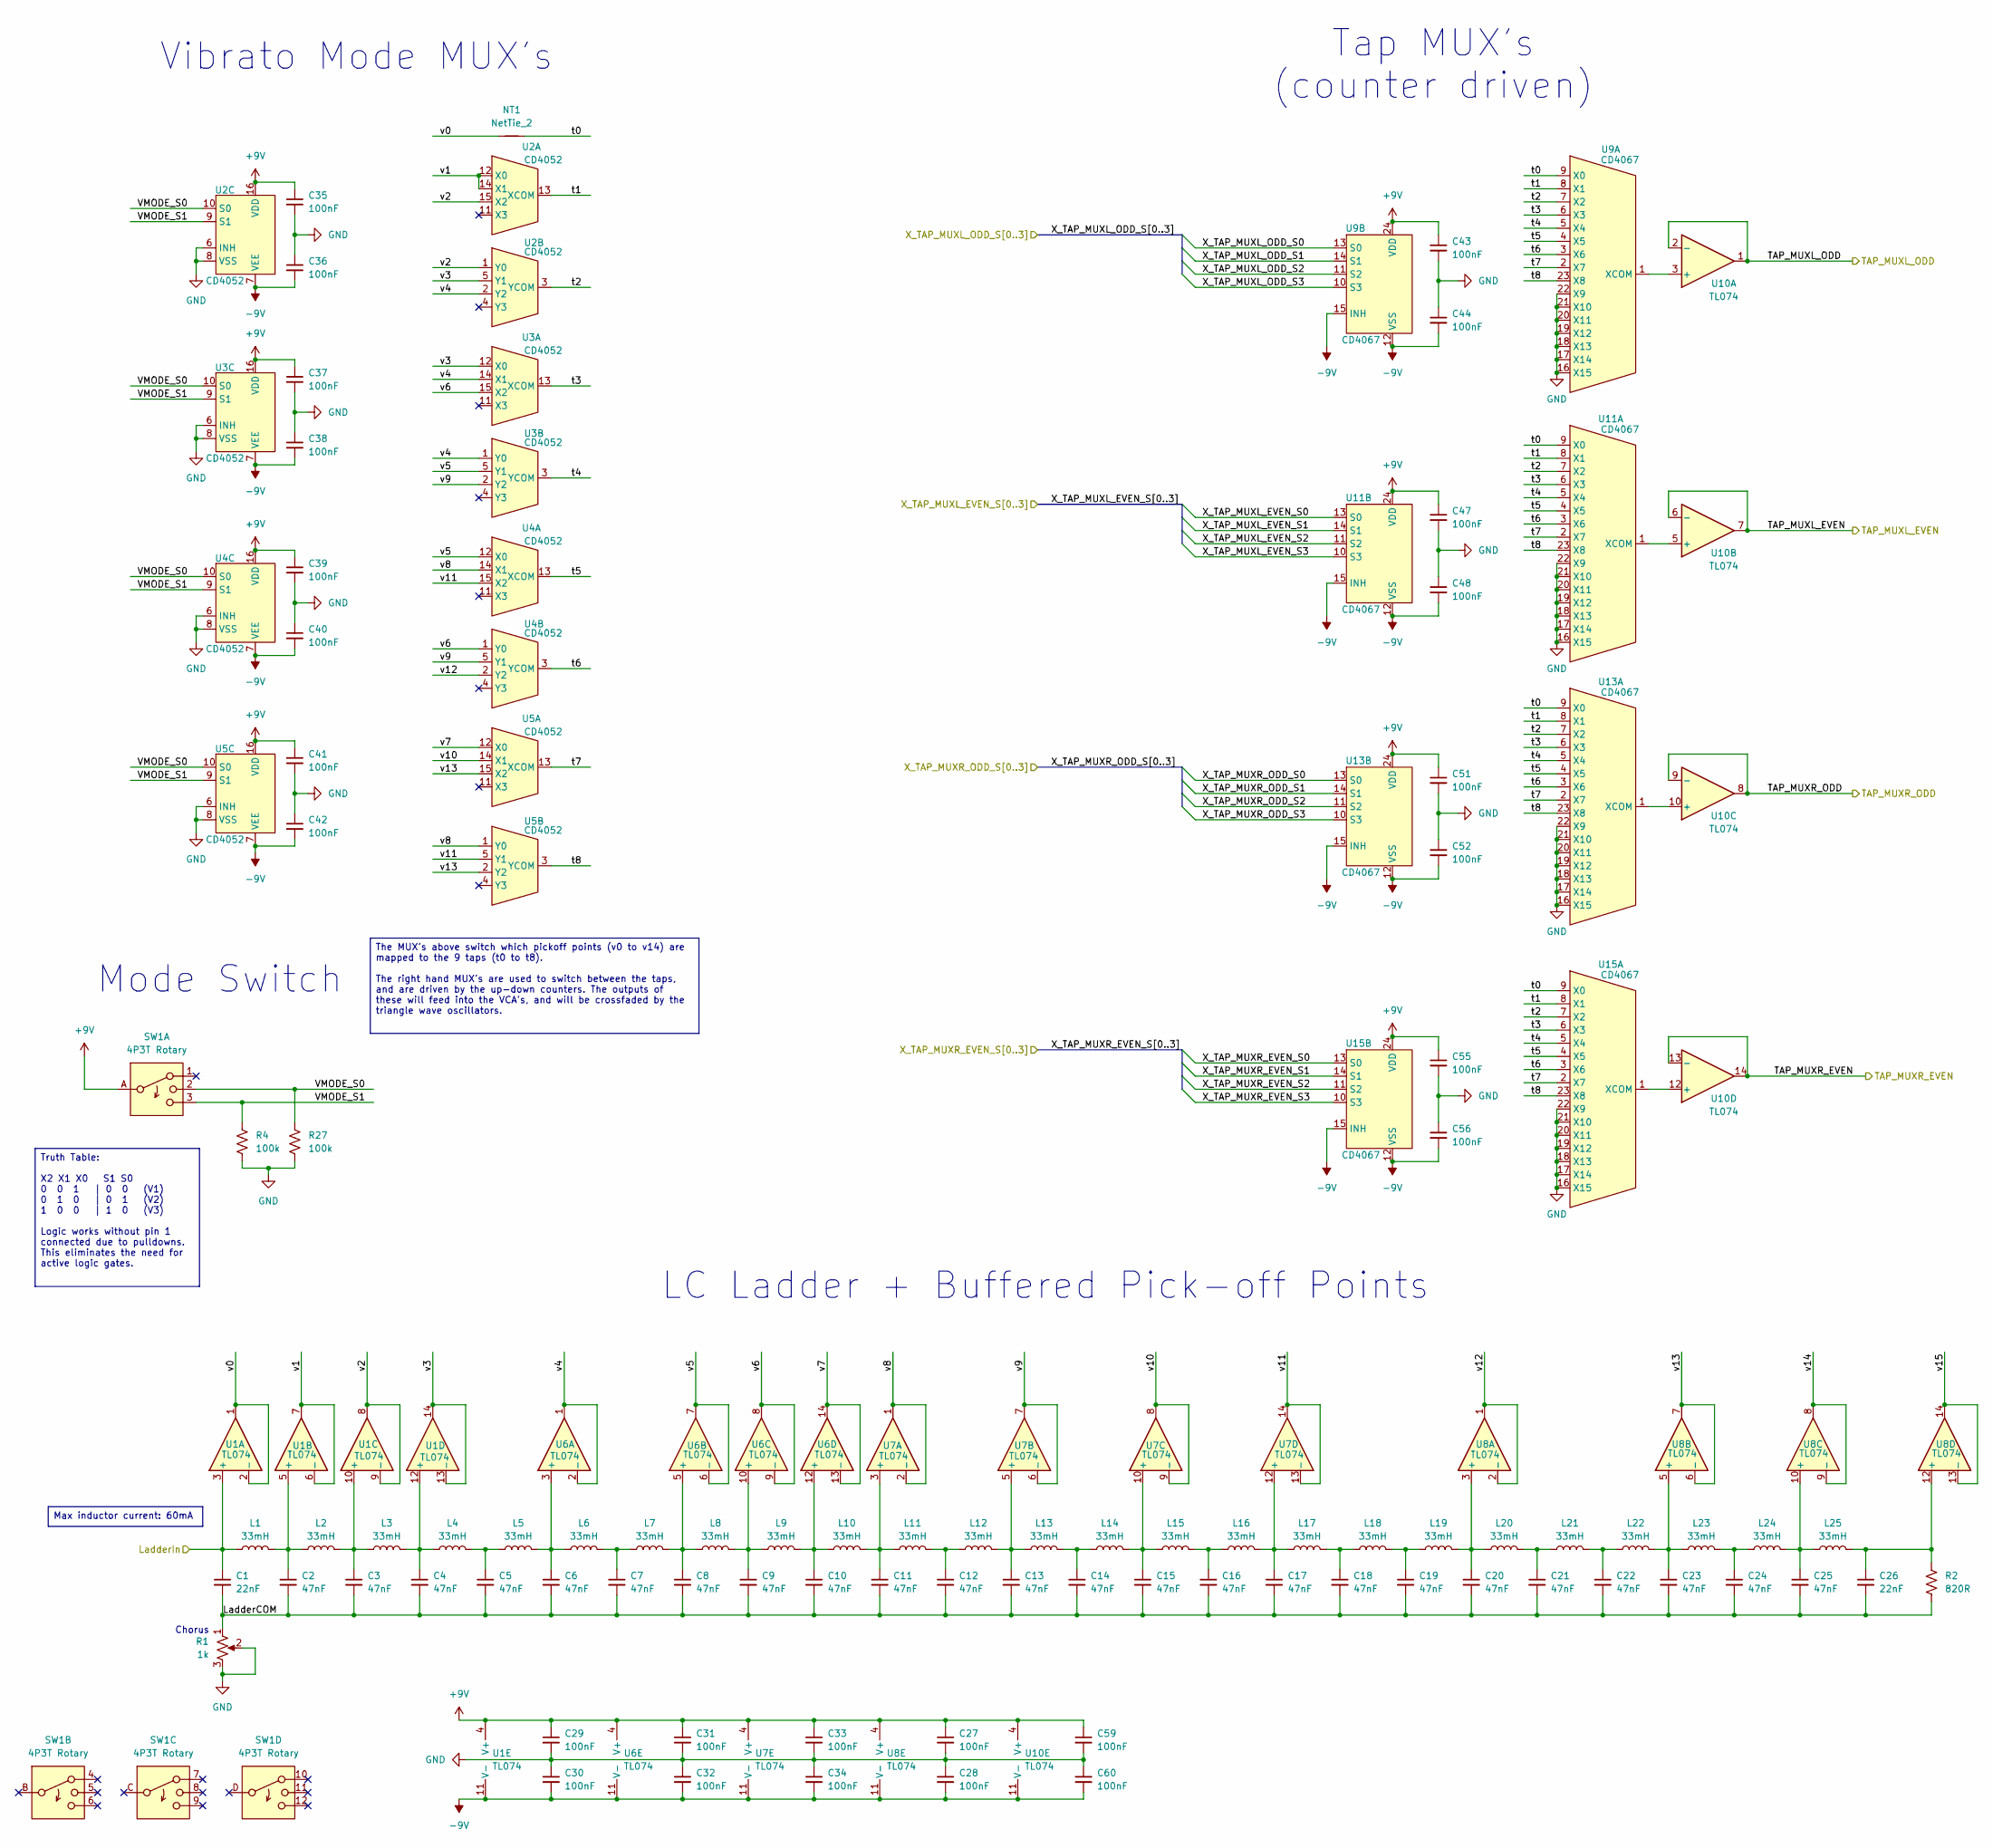
[picture p17: schematic Ladder_MUX.kicad_sch, Solid State Scanner Vibrato]

Parts:
C1, C26: 22nF; C_0603_1608Metric
C2, C3, C4, C5, C6, C7, C8, C9, C10, C11, C12, C13, C14, C15, C16, C17, C18, C19, C20, C21, C22, C23, C24, C25: 47nF; C_0603_1608Metric
C27, C28, C29, C30, C31, C32, C33, C34, C35, C36, C37, C38, C39, C40, C41, C42, C43, C44, C47, C48, C51, C52, C55, C56, C59, C60: 100nF; C_0603_1608Metric
L1, L2, L3, L4, L5, L6, L7, L8, L9, L10, L11, L12, L13, L14, L15, L16, L17, L18, L19, L20, L21, L22, L23, L24, L25: 33mH; 1300R_MUR; Part Number 13R336C
NT1: NetTie_2; NetTie-2_SMD_Pad0.5mm
R1: 1k; 16mm-POT-Right-Angle_LL; Part Number RV16AF-4M-15R1-B1K-EV
R2: 820R; R_0603_1608Metric
R4, R27: 100k; R_0603_1608Metric
SW1: 4P3T Rotary; SR2511 1P Hijack; Part Number SR2612F-0403-18R0B-D8-N
U1, U6, U7, U8, U10: TL074; TSSOP-14_4.4x5mm_P0.65mm; Part Number TL074HIPWR
U2, U3, U4, U5: CD4052; TSSOP-16_4.4x5mm_P0.65mm; Part Number CD4052BPWR
U9, U11, U13, U15: CD4067; TSSOP-24_4.4x7.8mm_P0.65mm; Part Number CD4067BPWR

Connections:
+9V: C27.1, C29.1, C31.1, C33.1, C35.1, C37.1, C39.1, C41.1, C43.1, C47.1, C51.1, C55.1, C59.1, SW1.A, U1.4 (V+), U2.16 (VDD), U3.16 (VDD), U4.16 (VDD), U5.16 (VDD), U6.4 (V+), U7.4 (V+), U8.4 (V+), U9.24 (VDD), U10.4 (V+), U11.24 (VDD), U13.24 (VDD), U15.24 (VDD); also elsewhere on the board
-9V: C28.2, C30.2, C32.2, C34.2, C36.2, C38.2, C40.2, C42.2, C44.2, C48.2, C52.2, C56.2, C60.2, U1.11 (V-), U2.7 (VEE), U3.7 (VEE), U4.7 (VEE), U5.7 (VEE), U6.11 (V-), U7.11 (V-), U8.11 (V-), U9.12 (VSS), U9.15 (INH), U10.11 (V-), U11.12 (VSS), U11.15 (INH), U13.12 (VSS), U13.15 (INH), U15.12 (VSS), U15.15 (INH); also elsewhere on the board
/Counters/X_TAP_MUXL_EVEN_S0: U11.13 (S0); also elsewhere on the board
/Counters/X_TAP_MUXL_EVEN_S1: U11.14 (S1); also elsewhere on the board
/Counters/X_TAP_MUXL_EVEN_S2: U11.11 (S2); also elsewhere on the board
/Counters/X_TAP_MUXL_EVEN_S3: U11.10 (S3); also elsewhere on the board
/Counters/X_TAP_MUXL_ODD_S0: U9.13 (S0); also elsewhere on the board
/Counters/X_TAP_MUXL_ODD_S1: U9.14 (S1); also elsewhere on the board
/Counters/X_TAP_MUXL_ODD_S2: U9.11 (S2); also elsewhere on the board
/Counters/X_TAP_MUXL_ODD_S3: U9.10 (S3); also elsewhere on the board
/Counters/X_TAP_MUXR_EVEN_S0: U15.13 (S0); also elsewhere on the board
/Counters/X_TAP_MUXR_EVEN_S1: U15.14 (S1); also elsewhere on the board
/Counters/X_TAP_MUXR_EVEN_S2: U15.11 (S2); also elsewhere on the board
/Counters/X_TAP_MUXR_EVEN_S3: U15.10 (S3); also elsewhere on the board
/Counters/X_TAP_MUXR_ODD_S0: U13.13 (S0); also elsewhere on the board
/Counters/X_TAP_MUXR_ODD_S1: U13.14 (S1); also elsewhere on the board
/Counters/X_TAP_MUXR_ODD_S2: U13.11 (S2); also elsewhere on the board
/Counters/X_TAP_MUXR_ODD_S3: U13.10 (S3); also elsewhere on the board
/Ladder + Mux/LadderCOM: C1.2, C2.2, C3.2, C4.2, C5.2, C6.2, C7.2, C8.2, C9.2, C10.2, C11.2, C12.2, C13.2, C14.2, C15.2, C16.2, C17.2, C18.2, C19.2, C20.2, C21.2, C22.2, C23.2, C24.2, C25.2, C26.2, R1.1, R2.2
/Ladder + Mux/LadderIn: C1.1, L1.1, U1.3 (+); also elsewhere on the board
/Ladder + Mux/TAP_MUXL_EVEN: U10.6 (-), U10.7; also elsewhere on the board
/Ladder + Mux/TAP_MUXL_ODD: U10.1, U10.2 (-); also elsewhere on the board
/Ladder + Mux/TAP_MUXR_EVEN: U10.13 (-), U10.14; also elsewhere on the board
/Ladder + Mux/TAP_MUXR_ODD: U10.8, U10.9 (-); also elsewhere on the board
/Ladder + Mux/VMODE_S0: R27.1, SW1.2, U2.10 (S0), U3.10 (S0), U4.10 (S0), U5.10 (S0)
/Ladder + Mux/VMODE_S1: R4.1, SW1.3, U2.9 (S1), U3.9 (S1), U4.9 (S1), U5.9 (S1)
/Ladder + Mux/t0: NT1.2, U9.9 (X0), U11.9 (X0), U13.9 (X0), U15.9 (X0)
/Ladder + Mux/t1: U2.13 (XCOM), U9.8 (X1), U11.8 (X1), U13.8 (X1), U15.8 (X1)
/Ladder + Mux/t2: U2.3 (YCOM), U9.7 (X2), U11.7 (X2), U13.7 (X2), U15.7 (X2)
/Ladder + Mux/t3: U3.13 (XCOM), U9.6 (X3), U11.6 (X3), U13.6 (X3), U15.6 (X3)
/Ladder + Mux/t4: U3.3 (YCOM), U9.5 (X4), U11.5 (X4), U13.5 (X4), U15.5 (X4)
/Ladder + Mux/t5: U4.13 (XCOM), U9.4 (X5), U11.4 (X5), U13.4 (X5), U15.4 (X5)
/Ladder + Mux/t6: U4.3 (YCOM), U9.3 (X6), U11.3 (X6), U13.3 (X6), U15.3 (X6)
/Ladder + Mux/t7: U5.13 (XCOM), U9.2 (X7), U11.2 (X7), U13.2 (X7), U15.2 (X7)
/Ladder + Mux/t8: U5.3 (YCOM), U9.23 (X8), U11.23 (X8), U13.23 (X8), U15.23 (X8)
/Ladder + Mux/v0: NT1.1, U1.1, U1.2 (-)
/Ladder + Mux/v1: U1.6 (-), U1.7, U2.12 (X0), U2.14 (X1)
/Ladder + Mux/v2: U1.8, U1.9 (-), U2.1 (Y0), U2.15 (X2)
/Ladder + Mux/v3: U1.13 (-), U1.14, U2.5 (Y1), U3.12 (X0)
/Ladder + Mux/v4: U2.2 (Y2), U3.1 (Y0), U3.14 (X1), U6.1, U6.2 (-)
/Ladder + Mux/v5: U3.5 (Y1), U4.12 (X0), U6.6 (-), U6.7
/Ladder + Mux/v6: U3.15 (X2), U4.1 (Y0), U6.8, U6.9 (-)
/Ladder + Mux/v7: U5.12 (X0), U6.13 (-), U6.14
/Ladder + Mux/v8: U4.14 (X1), U5.1 (Y0), U7.1, U7.2 (-)
/Ladder + Mux/v9: U3.2 (Y2), U4.5 (Y1), U7.6 (-), U7.7
/Ladder + Mux/v10: U5.14 (X1), U7.8, U7.9 (-)
/Ladder + Mux/v11: U4.15 (X2), U5.5 (Y1), U7.13 (-), U7.14
/Ladder + Mux/v12: U4.2 (Y2), U8.1, U8.2 (-)
/Ladder + Mux/v13: U5.2 (Y2), U5.15 (X2), U8.6 (-), U8.7
/Ladder + Mux/v14: U8.8, U8.9 (-)
/Ladder + Mux/v15: U8.13 (-), U8.14
GND: C27.2, C28.1, C29.2, C30.1, C31.2, C32.1, C33.2, C34.1, C35.2, C36.1, C37.2, C38.1, C39.2, C40.1, C41.2, C42.1, C43.2, C44.1, C47.2, C48.1, C51.2, C52.1, C55.2, C56.1, C59.2, C60.1, R1.2, R1.3, R4.2, R27.2, U2.6 (INH), U2.8 (VSS), U3.6 (INH), U3.8 (VSS), U4.6 (INH), U4.8 (VSS), U5.6 (INH), U5.8 (VSS), U9.16 (X15), U9.17 (X14), U9.18 (X13), U9.19 (X12), U9.20 (X11), U9.21 (X10), U9.22 (X9), U11.16 (X15), U11.17 (X14), U11.18 (X13), U11.19 (X12), U11.20 (X11), U11.21 (X10), U11.22 (X9), U13.16 (X15), U13.17 (X14), U13.18 (X13), U13.19 (X12), U13.20 (X11), U13.21 (X10), U13.22 (X9), U15.16 (X15), U15.17 (X14), U15.18 (X13), U15.19 (X12), U15.20 (X11), U15.21 (X10), U15.22 (X9); also elsewhere on the board
unnamed: C5.1, L4.2, L5.1
unnamed: C7.1, L6.2, L7.1
unnamed: C12.1, L11.2, L12.1
unnamed: C14.1, L13.2, L14.1
unnamed: C16.1, L15.2, L16.1
unnamed: C18.1, L17.2, L18.1
unnamed: C19.1, L18.2, L19.1
unnamed: C21.1, L20.2, L21.1
unnamed: C22.1, L21.2, L22.1
unnamed: C24.1, L23.2, L24.1
unnamed: C2.1, L1.2, L2.1, U1.5 (+)
unnamed: C3.1, L2.2, L3.1, U1.10 (+)
unnamed: C4.1, L3.2, L4.1, U1.12 (+)
unnamed: C6.1, L5.2, L6.1, U6.3 (+)
unnamed: C8.1, L7.2, L8.1, U6.5 (+)
unnamed: C9.1, L8.2, L9.1, U6.10 (+)
unnamed: C10.1, L9.2, L10.1, U6.12 (+)
unnamed: C11.1, L10.2, L11.1, U7.3 (+)
unnamed: C13.1, L12.2, L13.1, U7.5 (+)
unnamed: C15.1, L14.2, L15.1, U7.10 (+)
unnamed: C17.1, L16.2, L17.1, U7.12 (+)
unnamed: C20.1, L19.2, L20.1, U8.3 (+)
unnamed: C23.1, L22.2, L23.1, U8.5 (+)
unnamed: C25.1, L24.2, L25.1, U8.10 (+)
unnamed: C26.1, L25.2, R2.1, U8.12 (+)
unnamed: U9.1 (XCOM), U10.3 (+)
unnamed: U10.5 (+), U11.1 (XCOM)
unnamed: U10.10 (+), U13.1 (XCOM)
unnamed: U10.12 (+), U15.1 (XCOM)

Notes on the sheet:
Tap MUX's (counter driven)
Mode Switch
Vibrato Mode MUX's
Chorus
LC Ladder + Buffered Pick-off Points
Truth Table: X2 X1 X0 S1 S0 0 0 1 | 0 0 (V1) 0 1 0 | 0 1 (V2) 1 0 0 | 1 0 (V3) Logic works without pin 1 connected due to pulldowns. This eliminates the need for active logic gates.
The MUX's above switch which pickoff points (v0 to v14) are mapped to the 9 taps (t0 to t8). The right hand MUX's are used to switch between the taps, and are driven by the up-down counters. The outputs of these will feed into the VCA's, and will be crossfaded by the triangle wave oscillators.
Max inductor current: 60mA

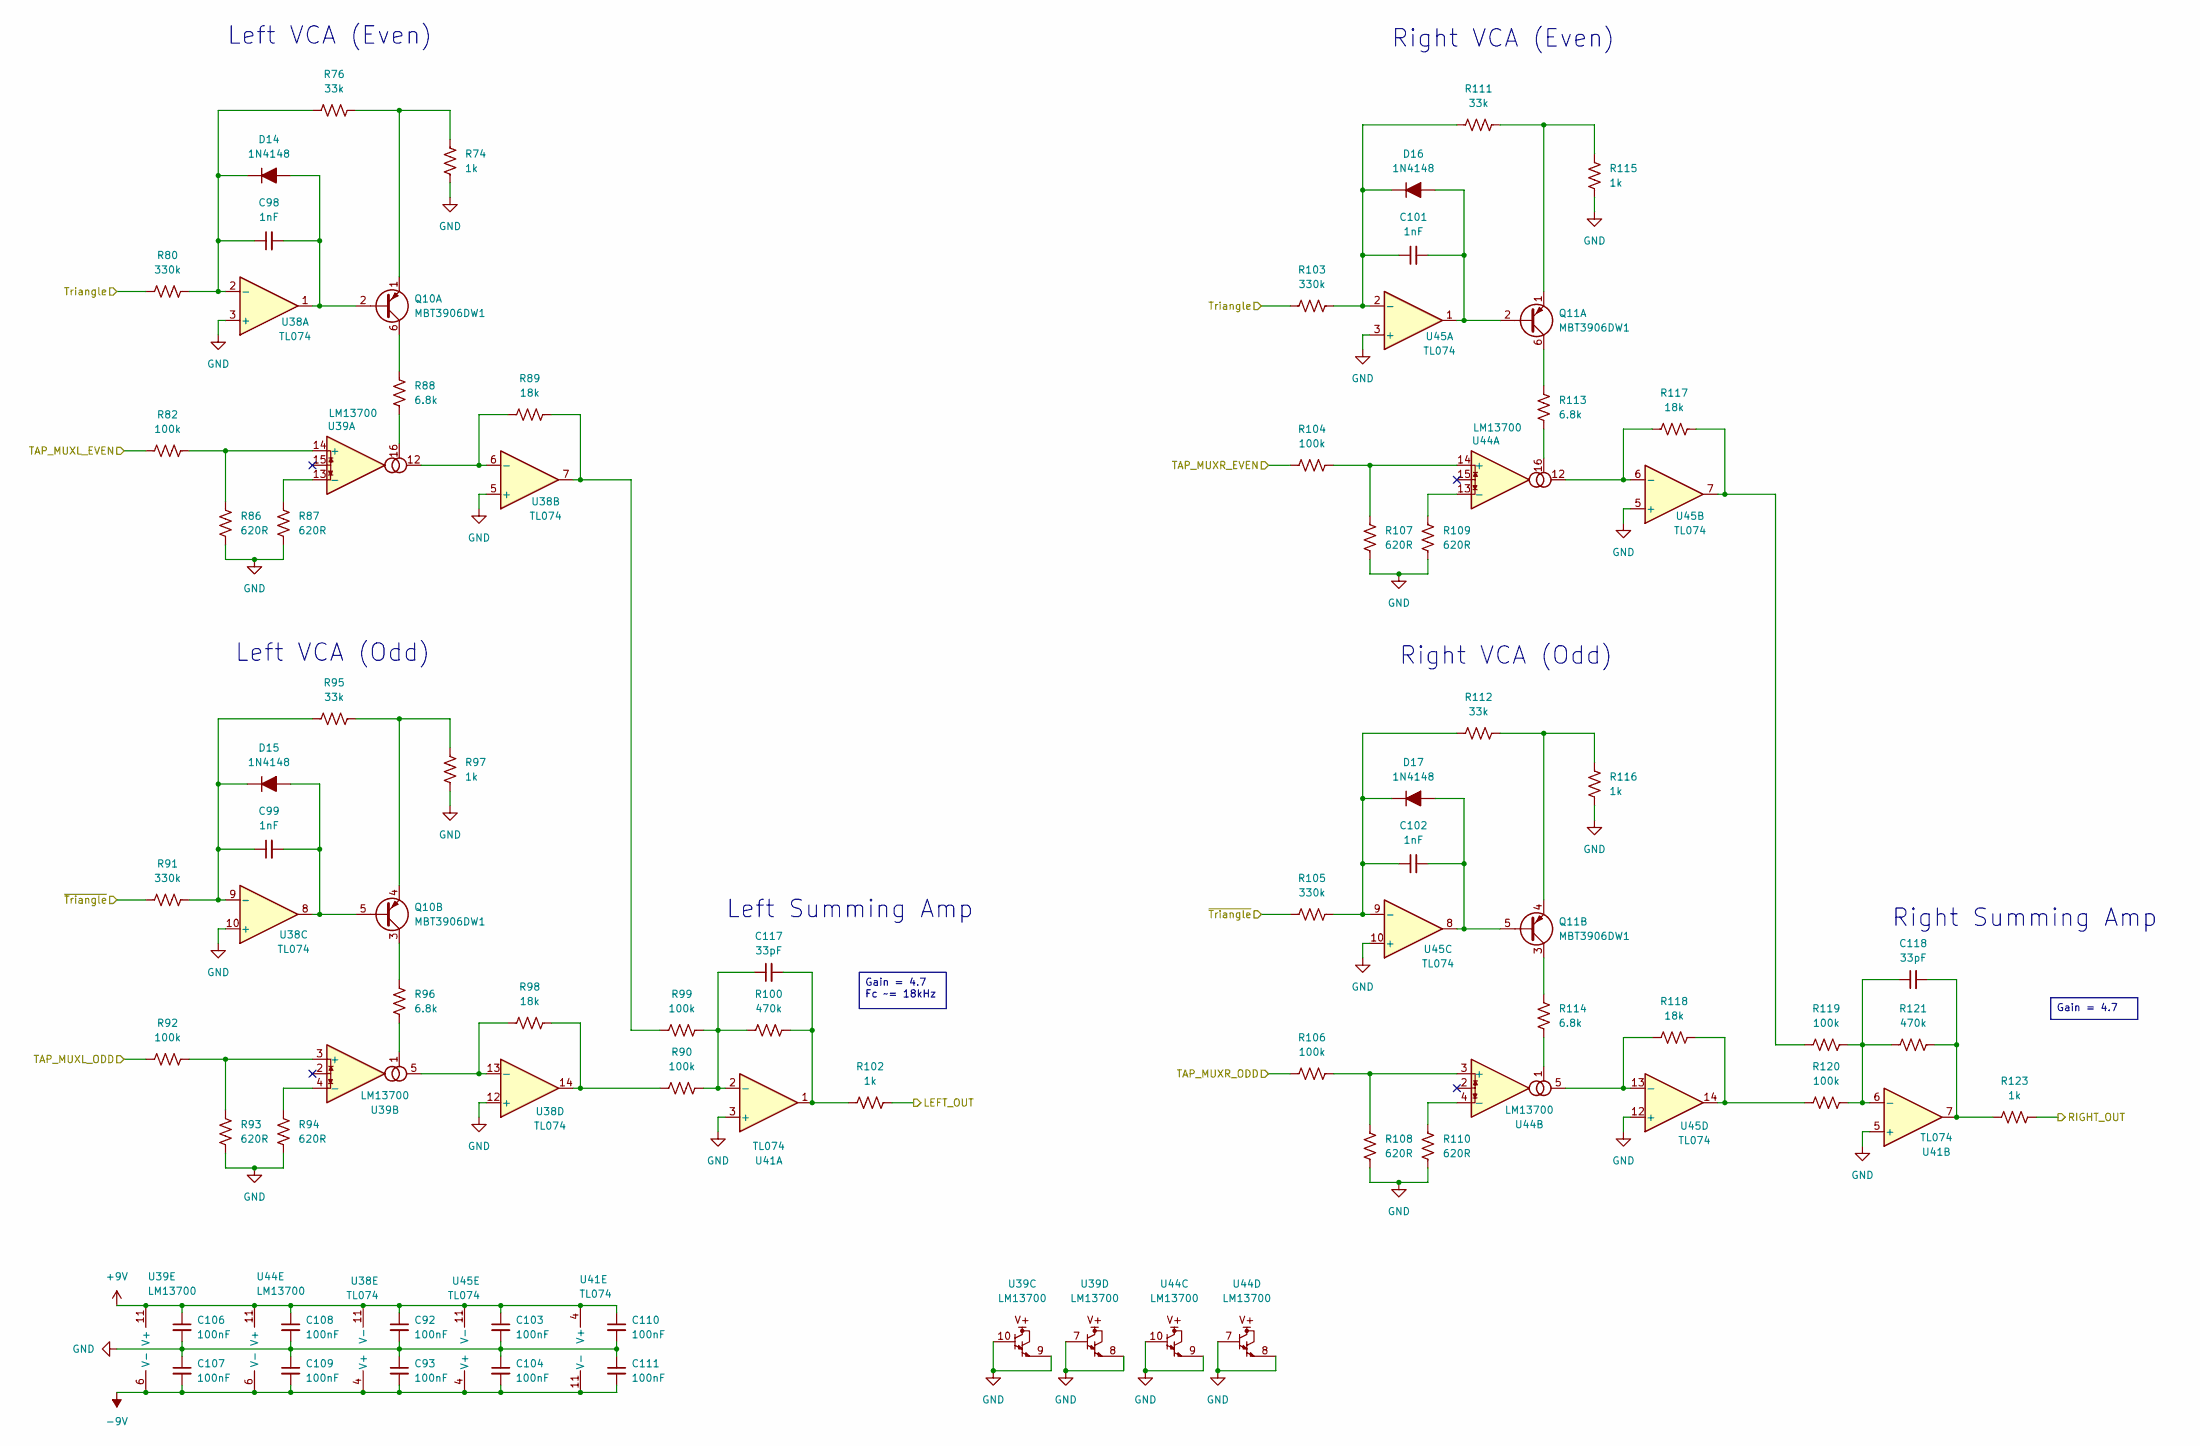
[picture p18: schematic VCA.kicad_sch, Solid State Scanner Vibrato]

Parts:
C92, C93, C103, C104, C106, C107, C108, C109, C110, C111: 100nF; C_0603_1608Metric
C98, C99, C101, C102: 1nF; C_0603_1608Metric
C117, C118: 33pF; C_0603_1608Metric
D14, D15, D16, D17: 1N4148; D_SOD-523; Part Number 1N4148WT
Q10, Q11: MBT3906DW1; SOT-363_SC-70-6; Part Number MBT3906DW1T1G
R74, R97, R102, R115, R116, R123: 1k; R_0603_1608Metric
R76, R95, R111, R112: 33k; R_0603_1608Metric
R80, R91, R103, R105: 330k; R_0603_1608Metric
R82, R90, R92, R99, R104, R106, R119, R120: 100k; R_0603_1608Metric
R86, R87, R93, R94, R107, R108, R109, R110: 620R; R_0603_1608Metric
R88, R96, R113, R114: 6.8k; R_0603_1608Metric
R89, R98, R117, R118: 18k; R_0603_1608Metric
R100, R121: 470k; R_0603_1608Metric
U38, U41, U45: TL074; TSSOP-14_4.4x5mm_P0.65mm; Part Number TL074HIPWR
U39, U44: LM13700; SOIC-16_3.9x9.9mm_P1.27mm; Part Number LM13700MX/NOPB

Connections:
+9V: C92.1, C103.1, C106.1, C108.1, C110.1, U38.11 (V-), U39.11 (V+), U41.4 (V+), U44.11 (V+), U45.11 (V-); also elsewhere on the board
-9V: C93.2, C104.2, C107.2, C109.2, C111.2, U38.4 (V+), U39.6 (V-), U41.11 (V-), U44.6 (V-), U45.4 (V+); also elsewhere on the board
/LED Array/Triangle: R80.2, R103.2; also elsewhere on the board
/LED Array/~Triangle: R91.2, R105.2; also elsewhere on the board
/Ladder + Mux/TAP_MUXL_EVEN: R82.2; also elsewhere on the board
/Ladder + Mux/TAP_MUXL_ODD: R92.2; also elsewhere on the board
/Ladder + Mux/TAP_MUXR_EVEN: R104.2; also elsewhere on the board
/Ladder + Mux/TAP_MUXR_ODD: R106.2; also elsewhere on the board
/VCAs/LEFT_OUT: R102.1; also elsewhere on the board
/VCAs/RIGHT_OUT: R123.1; also elsewhere on the board
GND: C92.2, C93.1, C103.2, C104.1, C106.2, C107.1, C108.2, C109.1, C110.2, C111.1, R74.1, R86.1, R87.1, R93.1, R94.1, R97.1, R107.1, R108.1, R109.1, R110.1, R115.1, R116.1, U38.3 (+), U38.5 (+), U38.10 (+), U38.12 (+), U39.7, U39.8, U39.9, U39.10, U41.3 (+), U41.5 (+), U44.7, U44.8, U44.9, U44.10, U45.3 (+), U45.5 (+), U45.10 (+), U45.12 (+); also elsewhere on the board
unnamed: C117.2, R100.1, R102.2, U41.1
unnamed: C118.2, R121.1, R123.2, U41.7
unnamed: C98.2, D14.2 (A), Q10.2 (B1), U38.1
unnamed: C98.1, D14.1 (K), R76.2, R80.1, U38.2 (-)
unnamed: C99.2, D15.2 (A), Q10.5 (B2), U38.8
unnamed: C99.1, D15.1 (K), R91.1, R95.2, U38.9 (-)
unnamed: C101.2, D16.2 (A), Q11.2 (B1), U45.1
unnamed: C101.1, D16.1 (K), R103.1, R111.2, U45.2 (-)
unnamed: C102.2, D17.2 (A), Q11.5 (B2), U45.8
unnamed: C102.1, D17.1 (K), R105.1, R112.2, U45.9 (-)
unnamed: Q10.6 (C1), R88.2
unnamed: Q10.1 (E1), R74.2, R76.1
unnamed: Q10.3 (C2), R96.2
unnamed: Q10.4 (E2), R95.1, R97.2
unnamed: Q11.6 (C1), R113.2
unnamed: Q11.1 (E1), R111.1, R115.2
unnamed: Q11.3 (C2), R114.2
unnamed: Q11.4 (E2), R112.1, R116.2
unnamed: R88.1, U39.16
unnamed: R89.1, R99.2, U38.7
unnamed: R90.2, R98.1, U38.14
unnamed: R96.1, U39.1
unnamed: R113.1, U44.16
unnamed: R114.1, U44.1
unnamed: R117.1, R119.2, U45.7
unnamed: R118.1, R120.2, U45.14
unnamed: R89.2, U38.6 (-), U39.12
unnamed: R98.2, U38.13 (-), U39.5
unnamed: R82.1, R86.2, U39.14 (+)
unnamed: R87.2, U39.13 (-)
unnamed: R92.1, R93.2, U39.3 (+)
unnamed: R94.2, U39.4 (-)
unnamed: C117.1, R90.1, R99.1, R100.2, U41.2 (-)
unnamed: C118.1, R119.1, R120.1, R121.2, U41.6 (-)
unnamed: R104.1, R107.2, U44.14 (+)
unnamed: R109.2, U44.13 (-)
unnamed: R106.1, R108.2, U44.3 (+)
unnamed: R110.2, U44.4 (-)
unnamed: R117.2, U44.12, U45.6 (-)
unnamed: R118.2, U44.5, U45.13 (-)

Notes on the sheet:
Right VCA (Even)
Left VCA (Odd)
Right Summing Amp
Right VCA (Odd)
Left Summing Amp
Left VCA (Even)
Gain = 4.7 Fc ~= 18kHz
Gain = 4.7

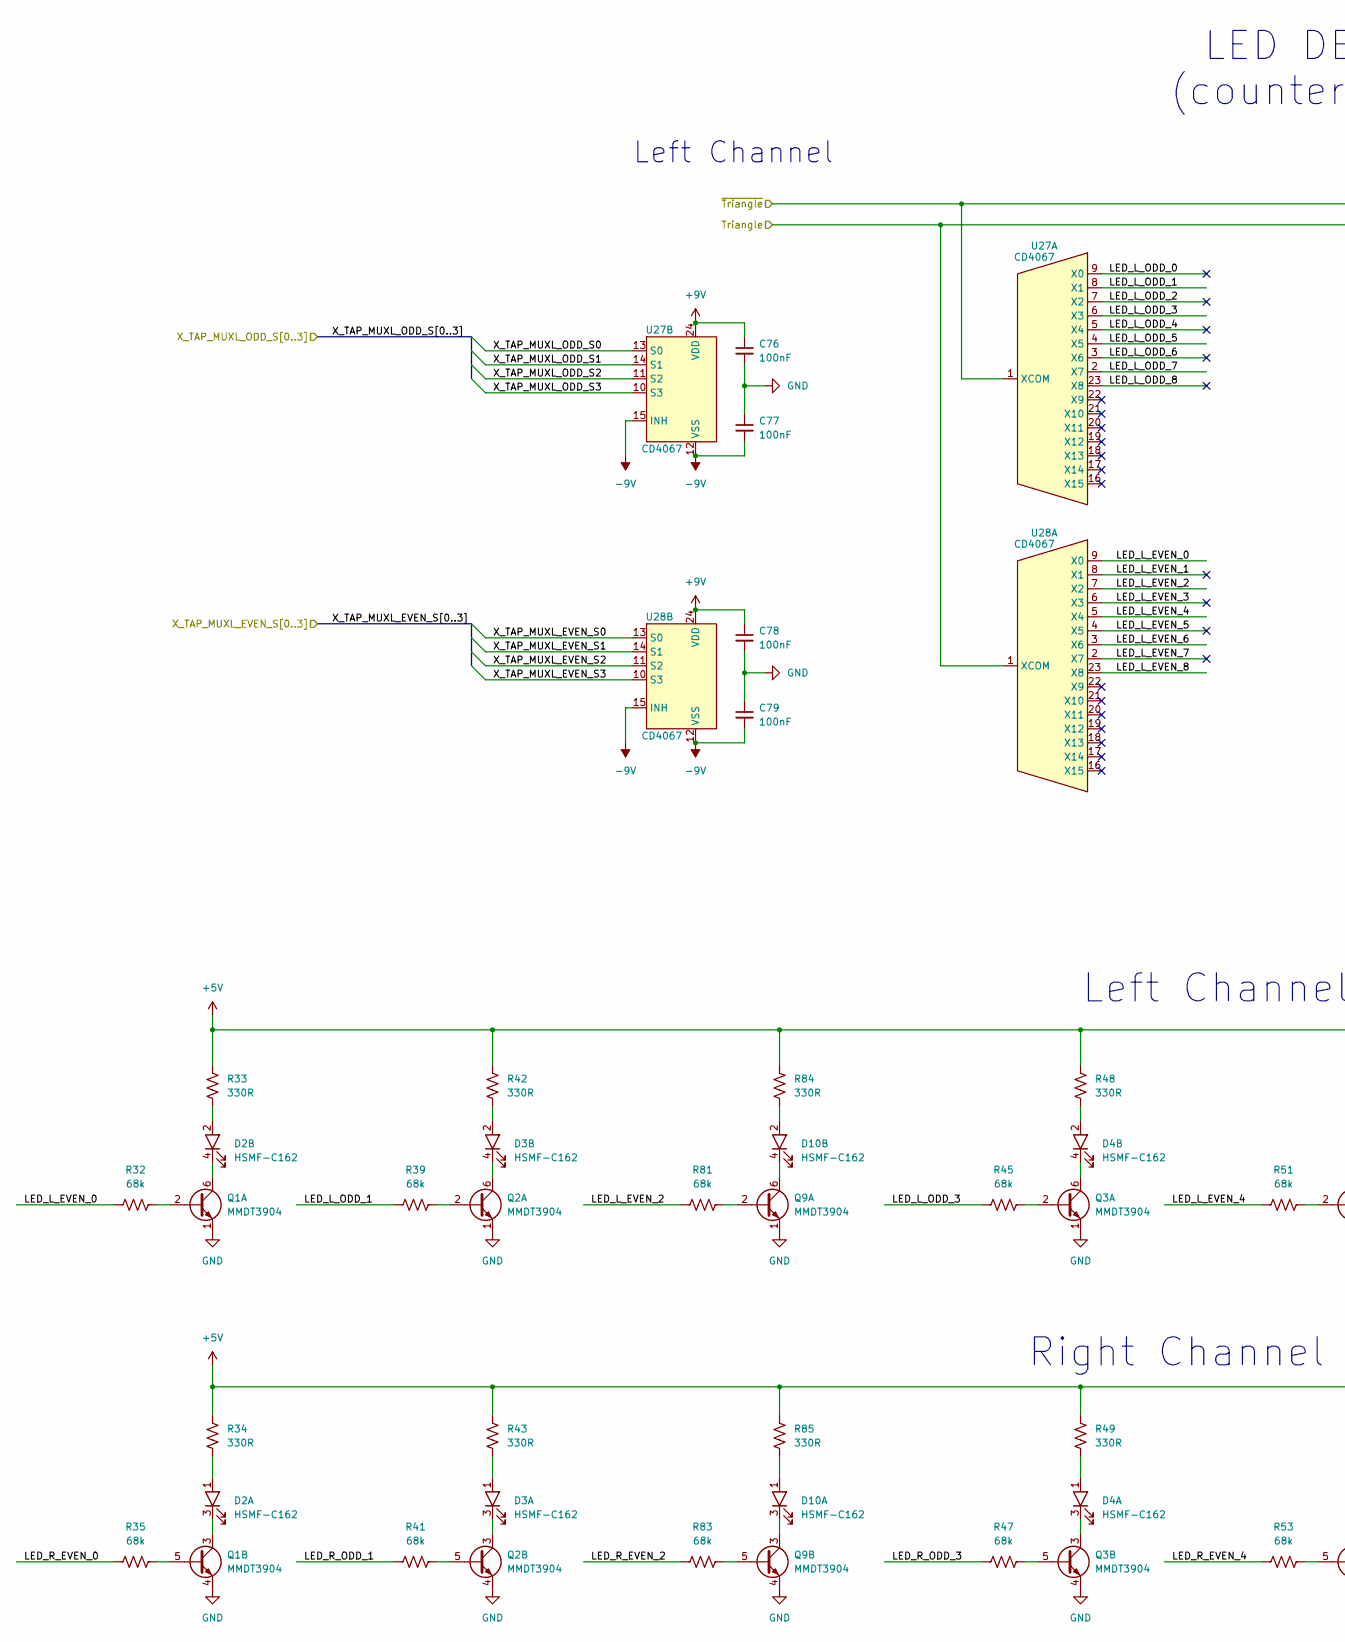
[picture p19: schematic LEDs.kicad_sch, Solid State Scanner Vibrato, part in row 1, column 1]

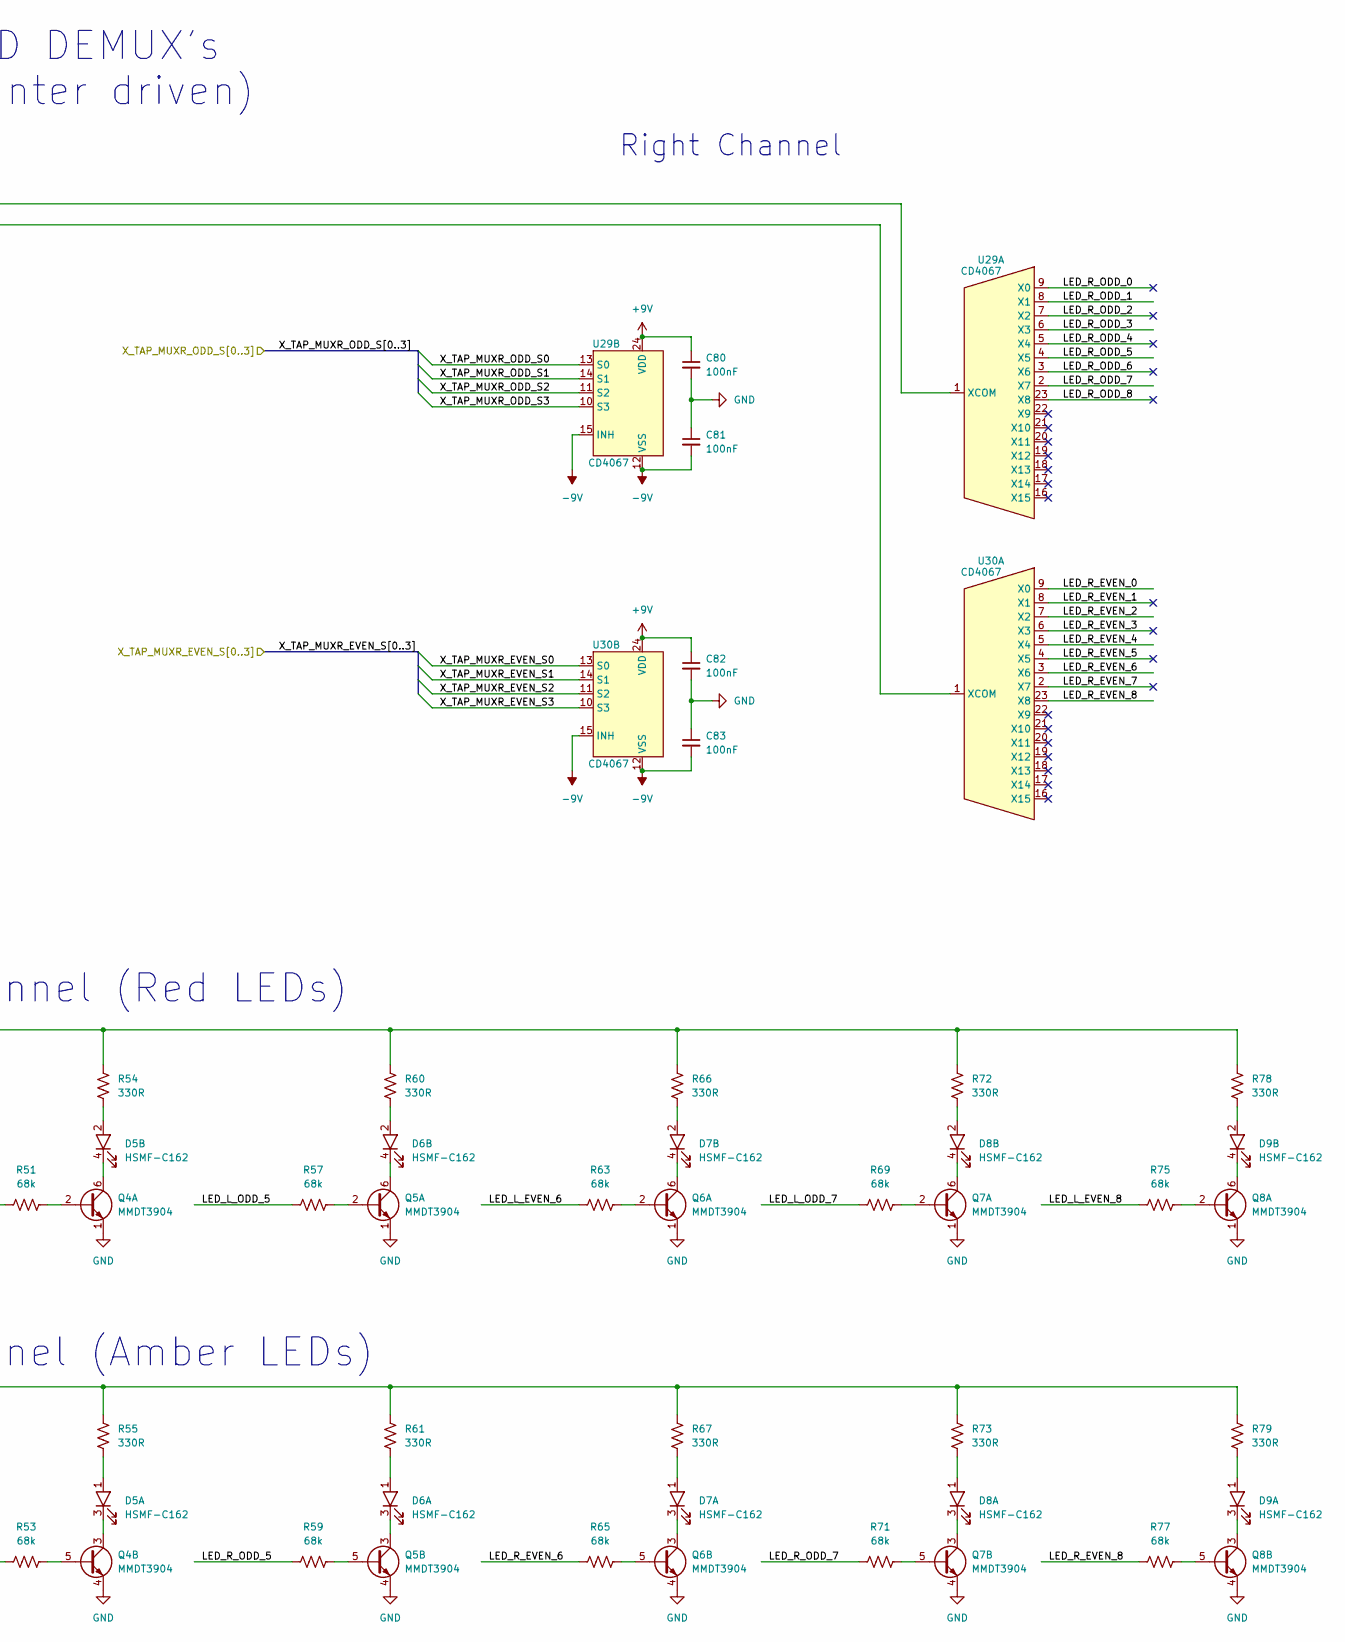
[picture p20: schematic LEDs.kicad_sch, Solid State Scanner Vibrato, part in row 1, column 2]

Parts:
C76, C77, C78, C79, C80, C81, C82, C83: 100nF; C_0603_1608Metric
D2, D3, D4, D5, D6, D7, D8, D9, D10: HSMF-C162; LED_HSMF-C162; Part Number HSMF-C162
Q1, Q2, Q3, Q4, Q5, Q6, Q7, Q8, Q9: MMDT3904; SOT-363_SC-70-6
R32, R35, R39, R41, R45, R47, R51, R53, R57, R59, R63, R65, R69, R71, R75, R77, R81, R83: 68k; R_0603_1608Metric
R33, R34, R42, R43, R48, R49, R54, R55, R60, R61, R66, R67, R72, R73, R78, R79, R84, R85: 330R; R_0603_1608Metric
U27, U28, U29, U30: CD4067; TSSOP-24_4.4x7.8mm_P0.65mm; Part Number CD4067BPWR

Connections:
+5V: R33.1, R34.1, R42.1, R43.1, R48.1, R49.1, R54.1, R55.1, R60.1, R61.1, R66.1, R67.1, R72.1, R73.1, R78.1, R79.1, R84.1, R85.1; also elsewhere on the board
+9V: C76.1, C78.1, C80.1, C82.1, U27.24 (VDD), U28.24 (VDD), U29.24 (VDD), U30.24 (VDD); also elsewhere on the board
-9V: C77.2, C79.2, C81.2, C83.2, U27.12 (VSS), U27.15 (INH), U28.12 (VSS), U28.15 (INH), U29.12 (VSS), U29.15 (INH), U30.12 (VSS), U30.15 (INH); also elsewhere on the board
/Counters/X_TAP_MUXL_EVEN_S0: U28.13 (S0); also elsewhere on the board
/Counters/X_TAP_MUXL_EVEN_S1: U28.14 (S1); also elsewhere on the board
/Counters/X_TAP_MUXL_EVEN_S2: U28.11 (S2); also elsewhere on the board
/Counters/X_TAP_MUXL_EVEN_S3: U28.10 (S3); also elsewhere on the board
/Counters/X_TAP_MUXL_ODD_S0: U27.13 (S0); also elsewhere on the board
/Counters/X_TAP_MUXL_ODD_S1: U27.14 (S1); also elsewhere on the board
/Counters/X_TAP_MUXL_ODD_S2: U27.11 (S2); also elsewhere on the board
/Counters/X_TAP_MUXL_ODD_S3: U27.10 (S3); also elsewhere on the board
/Counters/X_TAP_MUXR_EVEN_S0: U30.13 (S0); also elsewhere on the board
/Counters/X_TAP_MUXR_EVEN_S1: U30.14 (S1); also elsewhere on the board
/Counters/X_TAP_MUXR_EVEN_S2: U30.11 (S2); also elsewhere on the board
/Counters/X_TAP_MUXR_EVEN_S3: U30.10 (S3); also elsewhere on the board
/Counters/X_TAP_MUXR_ODD_S0: U29.13 (S0); also elsewhere on the board
/Counters/X_TAP_MUXR_ODD_S1: U29.14 (S1); also elsewhere on the board
/Counters/X_TAP_MUXR_ODD_S2: U29.11 (S2); also elsewhere on the board
/Counters/X_TAP_MUXR_ODD_S3: U29.10 (S3); also elsewhere on the board
/LED Array/LED_L_EVEN_0: R32.1, U28.9 (X0)
/LED Array/LED_L_EVEN_1: U28.8 (X1)
/LED Array/LED_L_EVEN_2: R81.1, U28.7 (X2)
/LED Array/LED_L_EVEN_3: U28.6 (X3)
/LED Array/LED_L_EVEN_4: R51.1, U28.5 (X4)
/LED Array/LED_L_EVEN_5: U28.4 (X5)
/LED Array/LED_L_EVEN_6: R63.1, U28.3 (X6)
/LED Array/LED_L_EVEN_7: U28.2 (X7)
/LED Array/LED_L_EVEN_8: R75.1, U28.23 (X8)
/LED Array/LED_L_ODD_0: U27.9 (X0)
/LED Array/LED_L_ODD_1: R39.1, U27.8 (X1)
/LED Array/LED_L_ODD_2: U27.7 (X2)
/LED Array/LED_L_ODD_3: R45.1, U27.6 (X3)
/LED Array/LED_L_ODD_4: U27.5 (X4)
/LED Array/LED_L_ODD_5: R57.1, U27.4 (X5)
/LED Array/LED_L_ODD_6: U27.3 (X6)
/LED Array/LED_L_ODD_7: R69.1, U27.2 (X7)
/LED Array/LED_L_ODD_8: U27.23 (X8)
/LED Array/LED_R_EVEN_0: R35.1, U30.9 (X0)
/LED Array/LED_R_EVEN_1: U30.8 (X1)
/LED Array/LED_R_EVEN_2: R83.1, U30.7 (X2)
/LED Array/LED_R_EVEN_3: U30.6 (X3)
/LED Array/LED_R_EVEN_4: R53.1, U30.5 (X4)
/LED Array/LED_R_EVEN_5: U30.4 (X5)
/LED Array/LED_R_EVEN_6: R65.1, U30.3 (X6)
/LED Array/LED_R_EVEN_7: U30.2 (X7)
/LED Array/LED_R_EVEN_8: R77.1, U30.23 (X8)
/LED Array/LED_R_ODD_0: U29.9 (X0)
/LED Array/LED_R_ODD_1: R41.1, U29.8 (X1)
/LED Array/LED_R_ODD_2: U29.7 (X2)
/LED Array/LED_R_ODD_3: R47.1, U29.6 (X3)
/LED Array/LED_R_ODD_4: U29.5 (X4)
/LED Array/LED_R_ODD_5: R59.1, U29.4 (X5)
/LED Array/LED_R_ODD_6: U29.3 (X6)
/LED Array/LED_R_ODD_7: R71.1, U29.2 (X7)
/LED Array/LED_R_ODD_8: U29.23 (X8)
/LED Array/Triangle: U28.1 (XCOM), U30.1 (XCOM); also elsewhere on the board
/LED Array/~Triangle: U27.1 (XCOM), U29.1 (XCOM); also elsewhere on the board
GND: C76.2, C77.1, C78.2, C79.1, C80.2, C81.1, C82.2, C83.1, Q1.1 (E1), Q1.4 (E2), Q2.1 (E1), Q2.4 (E2), Q3.1 (E1), Q3.4 (E2), Q4.1 (E1), Q4.4 (E2), Q5.1 (E1), Q5.4 (E2), Q6.1 (E1), Q6.4 (E2), Q7.1 (E1), Q7.4 (E2), Q8.1 (E1), Q8.4 (E2), Q9.1 (E1), Q9.4 (E2); also elsewhere on the board
unnamed: D2.1 (A_A), R34.2
unnamed: D2.3 (A_K), Q1.3 (C2)
unnamed: D2.2 (R_A), R33.2
unnamed: D2.4 (R_K), Q1.6 (C1)
unnamed: D3.1 (A_A), R43.2
unnamed: D3.3 (A_K), Q2.3 (C2)
unnamed: D3.2 (R_A), R42.2
unnamed: D3.4 (R_K), Q2.6 (C1)
unnamed: D4.1 (A_A), R49.2
unnamed: D4.3 (A_K), Q3.3 (C2)
unnamed: D4.2 (R_A), R48.2
unnamed: D4.4 (R_K), Q3.6 (C1)
unnamed: D5.1 (A_A), R55.2
unnamed: D5.3 (A_K), Q4.3 (C2)
unnamed: D5.2 (R_A), R54.2
unnamed: D5.4 (R_K), Q4.6 (C1)
unnamed: D6.1 (A_A), R61.2
unnamed: D6.3 (A_K), Q5.3 (C2)
unnamed: D6.2 (R_A), R60.2
unnamed: D6.4 (R_K), Q5.6 (C1)
unnamed: D7.1 (A_A), R67.2
unnamed: D7.3 (A_K), Q6.3 (C2)
unnamed: D7.2 (R_A), R66.2
unnamed: D7.4 (R_K), Q6.6 (C1)
unnamed: D8.1 (A_A), R73.2
unnamed: D8.3 (A_K), Q7.3 (C2)
unnamed: D8.2 (R_A), R72.2
unnamed: D8.4 (R_K), Q7.6 (C1)
unnamed: D9.1 (A_A), R79.2
unnamed: D9.3 (A_K), Q8.3 (C2)
unnamed: D9.2 (R_A), R78.2
unnamed: D9.4 (R_K), Q8.6 (C1)
unnamed: D10.1 (A_A), R85.2
unnamed: D10.3 (A_K), Q9.3 (C2)
unnamed: D10.2 (R_A), R84.2
unnamed: D10.4 (R_K), Q9.6 (C1)
unnamed: Q1.2 (B1), R32.2
unnamed: Q1.5 (B2), R35.2
unnamed: Q2.2 (B1), R39.2
unnamed: Q2.5 (B2), R41.2
unnamed: Q3.2 (B1), R45.2
unnamed: Q3.5 (B2), R47.2
unnamed: Q4.2 (B1), R51.2
unnamed: Q4.5 (B2), R53.2
unnamed: Q5.2 (B1), R57.2
unnamed: Q5.5 (B2), R59.2
unnamed: Q6.2 (B1), R63.2
unnamed: Q6.5 (B2), R65.2
unnamed: Q7.2 (B1), R69.2
unnamed: Q7.5 (B2), R71.2
unnamed: Q8.2 (B1), R75.2
unnamed: Q8.5 (B2), R77.2
unnamed: Q9.2 (B1), R81.2
unnamed: Q9.5 (B2), R83.2

Notes on the sheet:
Right Channel
Left Channel (Red LEDs)
LED DEMUX's (counter driven)
Right Channel (Amber LEDs)
Left Channel
