pscorbett/ScannerVibrato-Eurorack/Electronics/Boards/ScannerVibrato_Main/ScannerVibratoFun_Eurorack.kicad_pcb

## KiCad design Electronics/Boards/ScannerVibrato_Main/ScannerVibratoFun_Eurorack.kicad_pcb (continued)

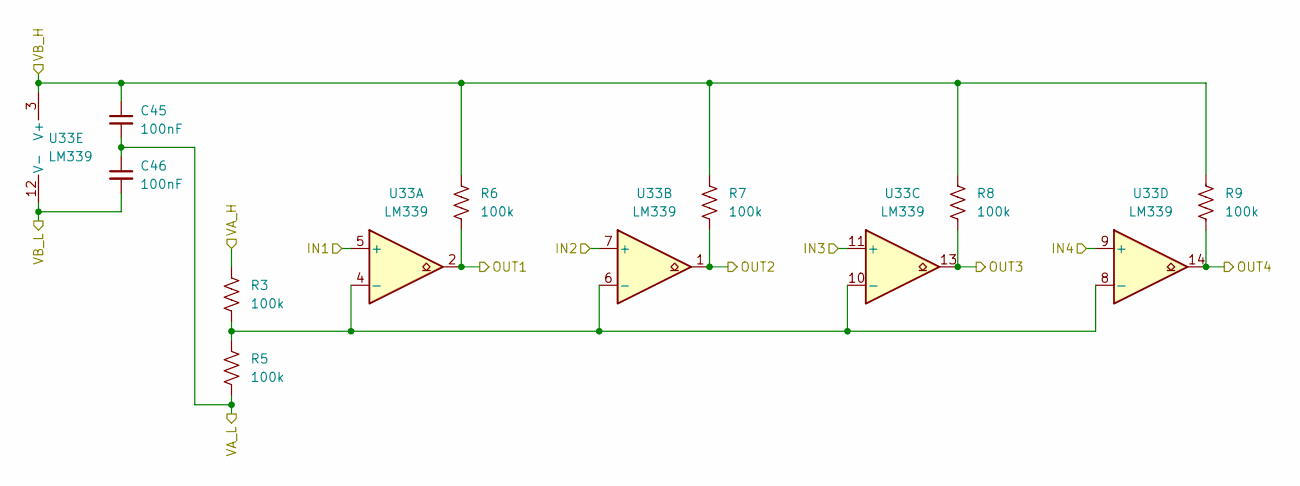
[picture p21: schematic Voltage_Translator.kicad_sch, Solid State Scanner Vibrato]

Parts:
C45, C46: 100nF; C_0603_1608Metric
R3, R5, R6, R7, R8, R9: 100k; R_0603_1608Metric
U33: LM339; TSSOP-14_4.4x5mm_P0.65mm; Part Number LM339APWR

Connections:
+5V: R3.1; also elsewhere on the board
+9V: C45.1, R6.1, R7.1, R8.1, R9.1, U33.3 (V+); also elsewhere on the board
-9V: C46.2, U33.12 (V-); also elsewhere on the board
/Counters/TAP_MUXL_ODD_S0: U33.5 (+); also elsewhere on the board
/Counters/TAP_MUXL_ODD_S1: U33.7 (+); also elsewhere on the board
/Counters/TAP_MUXL_ODD_S2: U33.11 (+); also elsewhere on the board
/Counters/TAP_MUXL_ODD_S3: U33.9 (+); also elsewhere on the board
/Counters/X_TAP_MUXL_ODD_S0: R6.2, U33.2; also elsewhere on the board
/Counters/X_TAP_MUXL_ODD_S1: R7.2, U33.1; also elsewhere on the board
/Counters/X_TAP_MUXL_ODD_S2: R8.2, U33.13; also elsewhere on the board
/Counters/X_TAP_MUXL_ODD_S3: R9.2, U33.14; also elsewhere on the board
GND: C45.2, C46.1, R5.2; also elsewhere on the board
unnamed: R3.2, R5.1, U33.4 (-), U33.6 (-), U33.8 (-), U33.10 (-)

Parts of its further copies:
C49, C50, C53, C54, C57, C58: 100nF; C_0603_1608Metric
R10, R11, R12, R13, R14, R15, R16, R17, R18, R19, R20, R21, R22, R23, R24, R25, R26, R31: 100k; R_0603_1608Metric
U34, U35, U36: LM339; TSSOP-14_4.4x5mm_P0.65mm; Part Number LM339APWR

Connections of its further copies:
+5V: R10.1, R16.1, R22.1; also elsewhere on the board
+9V: C49.1, C53.1, C57.1, R12.1, R13.1, R14.1, R15.1, R18.1, R19.1, R20.1, R21.1, R24.1, R25.1, R26.1, R31.1, U34.3 (V+), U35.3 (V+), U36.3 (V+); also elsewhere on the board
-9V: C50.2, C54.2, C58.2, U34.12 (V-), U35.12 (V-), U36.12 (V-); also elsewhere on the board
/Counters/TAP_MUXL_EVEN_S0: U34.5 (+); also elsewhere on the board
/Counters/TAP_MUXL_EVEN_S1: U34.7 (+); also elsewhere on the board
/Counters/TAP_MUXL_EVEN_S2: U34.11 (+); also elsewhere on the board
/Counters/TAP_MUXL_EVEN_S3: U34.9 (+); also elsewhere on the board
/Counters/TAP_MUXR_EVEN_S0: U36.5 (+); also elsewhere on the board
/Counters/TAP_MUXR_EVEN_S1: U36.7 (+); also elsewhere on the board
/Counters/TAP_MUXR_EVEN_S2: U36.11 (+); also elsewhere on the board
/Counters/TAP_MUXR_EVEN_S3: U36.9 (+); also elsewhere on the board
/Counters/TAP_MUXR_ODD_S0: U35.5 (+); also elsewhere on the board
/Counters/TAP_MUXR_ODD_S1: U35.7 (+); also elsewhere on the board
/Counters/TAP_MUXR_ODD_S2: U35.11 (+); also elsewhere on the board
/Counters/TAP_MUXR_ODD_S3: U35.9 (+); also elsewhere on the board
/Counters/X_TAP_MUXL_EVEN_S0: R12.2, U34.2; also elsewhere on the board
/Counters/X_TAP_MUXL_EVEN_S1: R13.2, U34.1; also elsewhere on the board
/Counters/X_TAP_MUXL_EVEN_S2: R14.2, U34.13; also elsewhere on the board
/Counters/X_TAP_MUXL_EVEN_S3: R15.2, U34.14; also elsewhere on the board
/Counters/X_TAP_MUXR_EVEN_S0: R24.2, U36.2; also elsewhere on the board
/Counters/X_TAP_MUXR_EVEN_S1: R25.2, U36.1; also elsewhere on the board
/Counters/X_TAP_MUXR_EVEN_S2: R26.2, U36.13; also elsewhere on the board
/Counters/X_TAP_MUXR_EVEN_S3: R31.2, U36.14; also elsewhere on the board
/Counters/X_TAP_MUXR_ODD_S0: R18.2, U35.2; also elsewhere on the board
/Counters/X_TAP_MUXR_ODD_S1: R19.2, U35.1; also elsewhere on the board
/Counters/X_TAP_MUXR_ODD_S2: R20.2, U35.13; also elsewhere on the board
/Counters/X_TAP_MUXR_ODD_S3: R21.2, U35.14; also elsewhere on the board
GND: C49.2, C50.1, C53.2, C54.1, C57.2, C58.1, R11.2, R17.2, R23.2; also elsewhere on the board
unnamed: R10.2, R11.1, U34.4 (-), U34.6 (-), U34.8 (-), U34.10 (-)
unnamed: R16.2, R17.1, U35.4 (-), U35.6 (-), U35.8 (-), U35.10 (-)
unnamed: R22.2, R23.1, U36.4 (-), U36.6 (-), U36.8 (-), U36.10 (-)

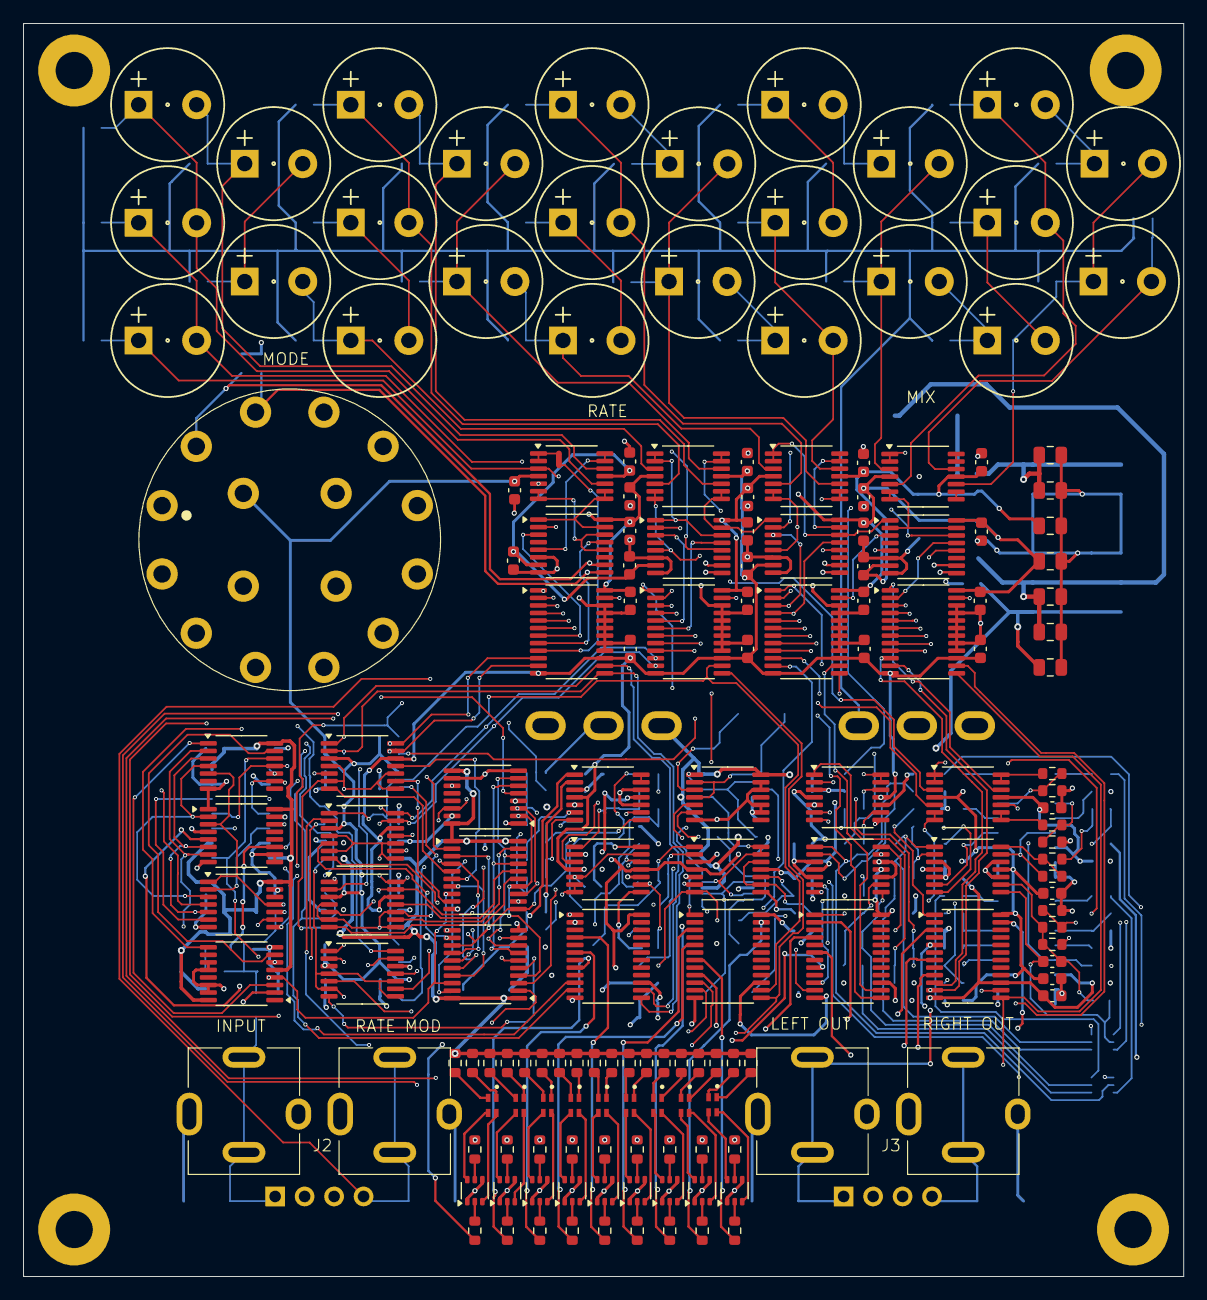
[picture p22: board ScannerVibratoFun_Eurorack.kicad_pcb from above]

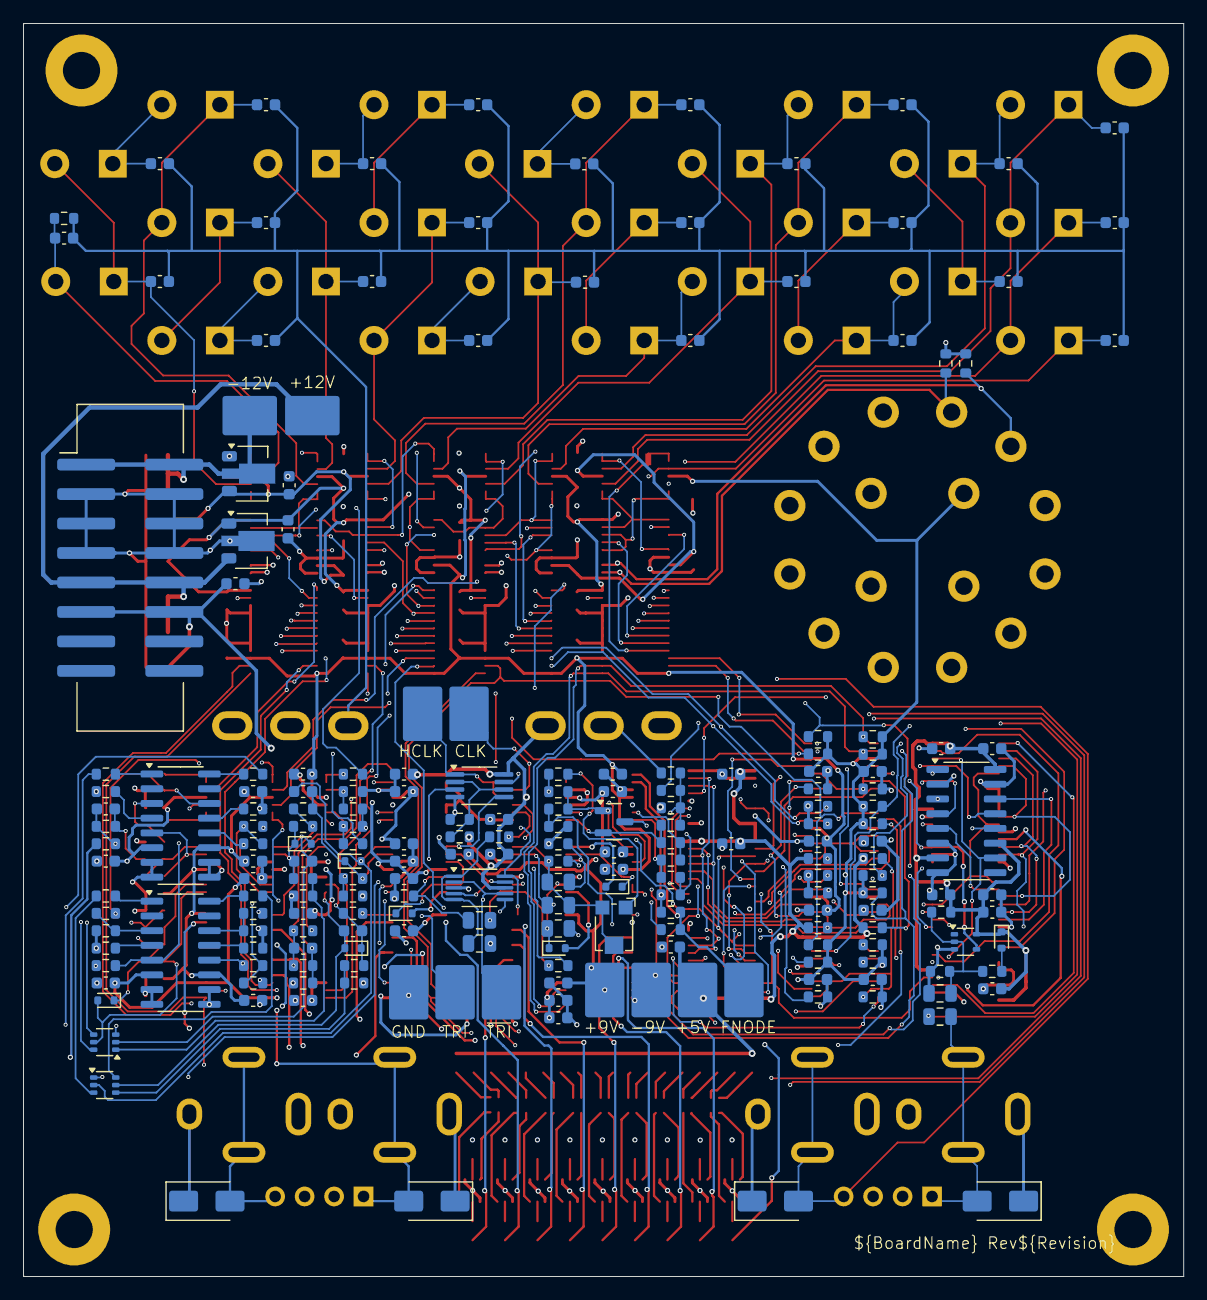
[picture p23: board ScannerVibratoFun_Eurorack.kicad_pcb from below]

Board: 4 copper layers, 100.0 x 108.0 mm, 371 parts (206 on the bottom side), 280 nets.
