pscorbett/ScannerVibrato-Eurorack/(commit log)

2025-08-02 Adding main and IO PCBs
    [Counters.kicad_sch, LC_Ladder.kicad_sch, LEDs.kicad_sch, LFO.kicad_sch, Ladder_MUX.kicad_sch, Power.kicad_sch, ScannerVibratoFun_Eurorack-Board Outline.dxf, ScannerVibratoFun_Eurorack-Bottom Signal.dxf]
2025-08-02 Adding Digital (logic) and Falstad (circuit) simulations
2025-08-02 Adding mechanical (FreeCAD) files and tap table
    [ScannerVibrato20HP_3D-Assembly.step, ScannerVibrato20HP_3D-PanelSketch007.dxf, ScannerVibrato20HP_3D-PanelSketch009.dxf, ScannerVibrato20HP_3D-PanelSketch010.dxf, ScannerVibrato20HP_3D-PartWindow.dxf, ScannerVibrato20HP_3D-Window001Sketch005.dxf]
